UHM-RoSE/instrumentation-and-control/(list of files, cad)

Other CAD files:
EPS/Debug/src/main.obj
EPS/Debug/src/uart.obj
