UHM-RoSE/instrumentation-and-control/(threads)

Thread 1 (2021-10-01):

Design EPS Block Diagram

CraigOpie, 2021-10-01:
Do work for this project in a branch named issue-001:

Design the EPS Block Diagram.  This should be the overall function of the EPS to include charging, discharging, and battery functions.

CraigOpie, 2021-10-01:
Block Diagram is located here:
https://drive.google.com/file/d/1deLKcMdyghD3iEOQf02tignTb7_-ttTG/view?usp=sharing

Closed 2021-10-01.

Thread 10 (2021-10-01):

Create EPS Board File

CraigOpie, 2021-10-01:
Do work for this project in a branch named issue-010:

Create the EPS Board File

Thread 11 (2021-10-01):

Create Bill Of Materials (BOM)

CraigOpie, 2021-10-01:
Do work for this project in a branch named issue-011:

Create the EPS BOM

Closed 2021-12-09.

Thread 13 (2021-10-01):

Implement EPS Register Designation and Memory Allocation Chart

CraigOpie, 2021-10-01:
Do work for this project in a branch named issue-013:

Implement the EPS Register Designation and Memory Allocation Chart to allow for

- [ ] Telemetry
- [ ] Watchdogs and Reset Counters
- [ ] PCM Control
- [ ] PDM Control
- [ ] PDM Timers

Closed 2021-12-09.

Thread 14 (2021-10-01):

Implement Communications Interface

CraigOpie, 2021-10-01:
Do work for this project in a branch named issue-014:

Implement the EPS Communications Interface to allow for

- [x] Setup UART Interrupts (Baud Rate 115200)
- [x] Perform UART Hardware Checks (O-Scope)
- [x] Perform UART Loop Back Test
- [x] Setup I2C Interrupts (Slave)
- [x] Perform I2C Hardware Checks (O-Scope)
- [x] Perform I2C Address and ACK Test
- [x] Command Protocol
- [x] List of Available Commands
        - [ ] Board Status
        - [ ] Get Last Error
        - [ ] Get Version
        - [ ] Get Checksum
        - [ ] Get Telemetry
        - [ ] Get Communications Watchdog Period
        - [ ] Set Communications Watchdog Period
        - [ ] Reset Communications Watchdog
        - [ ] Get Number of Brown-out Resets
        - [ ] Get Number of Auto Software Resets
        - [ ] Get Number of Manual Resets
        - [ ] Get Number of Communications Watchdog Resets
        - [ ] Switch ON All PDMs
        - [ ] Switch OFF All PDMs
        - [ ] Get Actual State of All PDMs
        - [ ] Get Expected State of All PDMs
        - [ ] Get Initial State of All PDMs
        - [ ] Set All PDMs to Initial State
        - [ ] Switch PDM-N "ON"
        - [ ] Switch PDM-N "OFF"
        - [ ] Set PDM-N's Initial State to "ON"
        - [ ] Set PDM-N's Initial State to "OFF"
        - [ ] Get PDM-N's Actual Status
        - [ ] Set PDM-N's Timer Limit
        - [ ] Get PDM-N's Timer Limit
        - [ ] Get PDM-N's Current Timer Value
        - [ ] PCM Reset
        - [ ] Manual Reset

Closed 2021-12-09.

Thread 15 (2021-10-01):

Finalize Schematic Design

CraigOpie, 2021-10-01:
Do work for this project in a branch named issue-015:

Finalize the Schematic Design

Closed 2021-12-09.

Thread 16 (2021-10-01):

Finalize Board Design

CraigOpie, 2021-10-01:
Do work for this project in a branch named issue-016:

Finalize the Board Design

Thread 17 (2021-10-01):

Assemble Final Board

CraigOpie, 2021-10-01:
Do work for this project in a branch named issue-017:

Assemble the Final Board

Thread 18 (2021-10-01):

Test the Final Board

CraigOpie, 2021-10-01:
Do work for this project in a branch named issue-018:

Test the Final Board

- [ ] Power Input Module
- [ ] Power Conditioning Module
- [ ] Power Distribution Module
- [ ] Battery Cells
- [ ] Communicate with EPS

Thread 2 (2021-10-01):

Select Components for the Power Input Module

CraigOpie, 2021-10-01:
Do work for this project in a branch named issue-002:

Select Components for the Power Input Module to allow charging the battery or running power from a non-battery power supply.

Closed 2021-12-09.

Thread 3 (2021-10-01):

Select Components for the Battery Maintaining Module

CraigOpie, 2021-10-01:
Do work for this project in a branch named issue-003:

Select Components for the Battery Maintaining Module to allow balanced charging of the battery cells, monitoring temperatures, and telemetry.

Closed 2021-12-09.

Thread 4 (2021-10-01):

Select Components for the Power Conditioning Module

CraigOpie, 2021-10-01:
Do work for this project in a branch named issue-004:

Select Components for the Power Conditioning Module to allow required protective features to the power supply voltage buses.

Closed 2021-12-09.

Thread 5 (2021-10-01):

Select Components for the Power Distribution Module

CraigOpie, 2021-10-01:
Do work for this project in a branch named issue-005:

Select Components for the Power Distribution Module to allow required protective features to the power supply switched outputs.

Closed 2021-12-09.

Thread 6 (2021-10-01):

Create Power Input Circuit Schematic

CraigOpie, 2021-10-01:
Do work for this project in a branch named issue-006:

Create the Power Input Circuit Schematic Page

Closed 2021-12-09.

Thread 7 (2021-10-01):

Create Battery Maintaining Circuit Schematic

CraigOpie, 2021-10-01:
Do work for this project in a branch named issue-007:

Create the Battery Maintaining Circuit Schematic Page

Closed 2021-12-09.

Thread 8 (2021-10-01):

Create Power Conditioning Module Schematic

CraigOpie, 2021-10-01:
Do work for this project in a branch named issue-008:

Create the Power Conditioning Module Schematic Page

Closed 2021-12-09.

Thread 9 (2021-10-01):

Create Power Distribution Module Schematic

CraigOpie, 2021-10-01:
Do work for this project in a branch named issue-009:

Create the Power Distribution Module Schematic Page

Closed 2021-12-09.
