UHM-RoSE/instrumentation-and-control/Documentation/EPS Schematic/eps.pdf

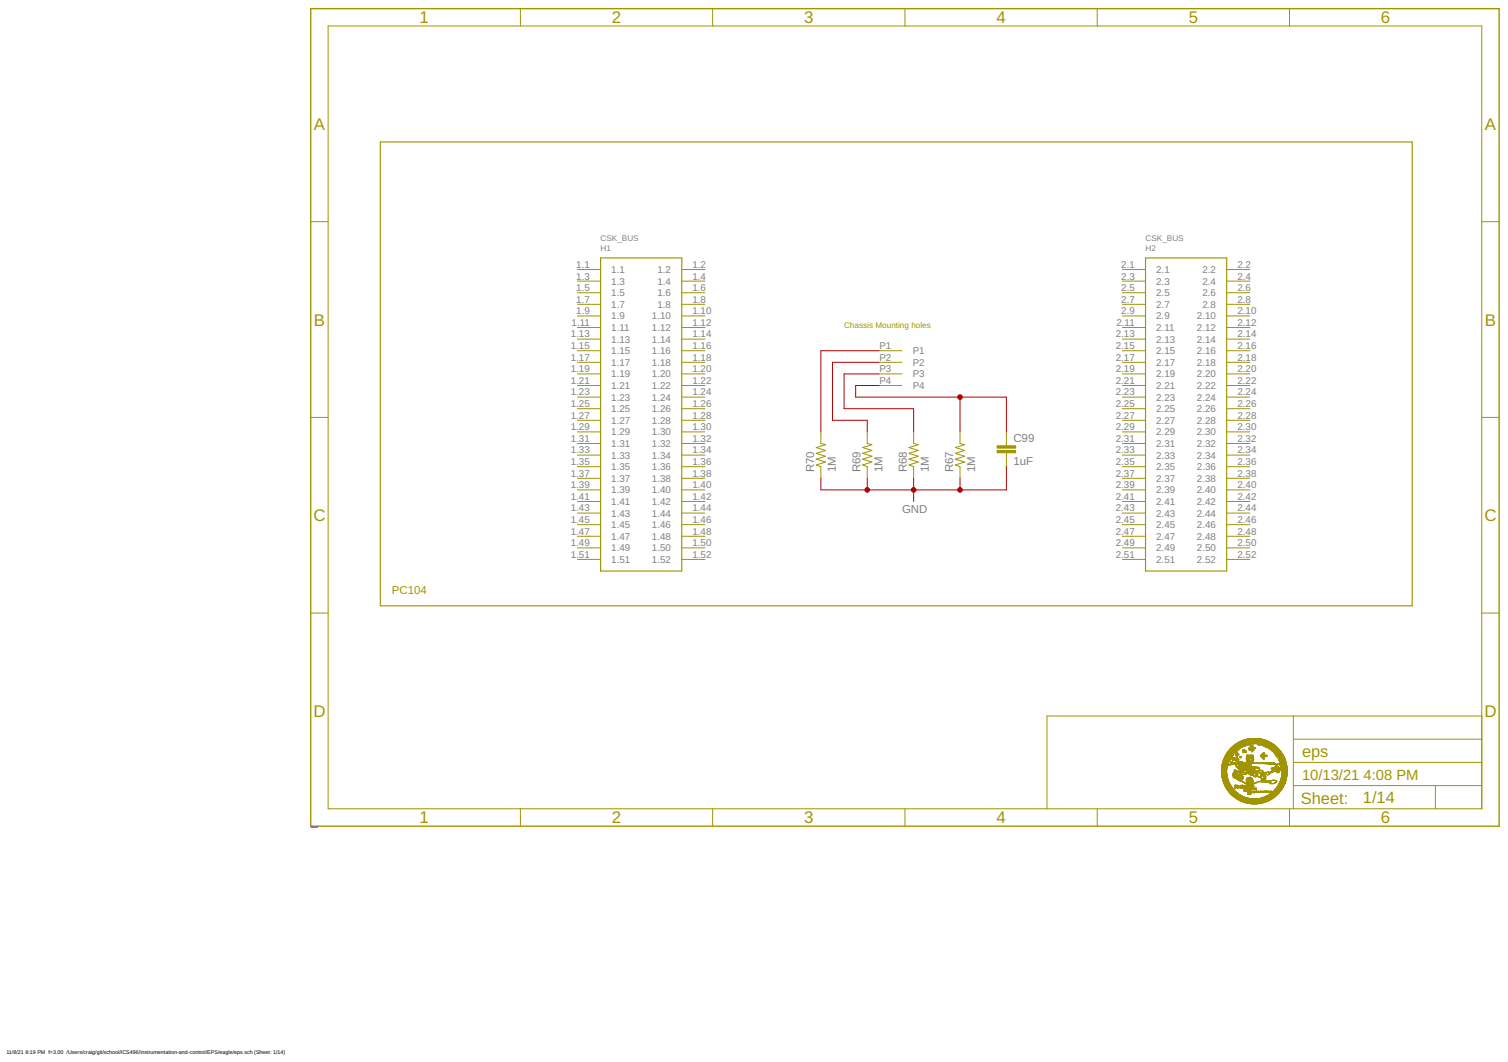
[picture p3: page 1]

11/8/21 8:19 PM f=3.00 /Users/craig/git/school/ICS496/instrumentation-and-control/EPS/eagle/eps.sch (Sheet: 1/14)

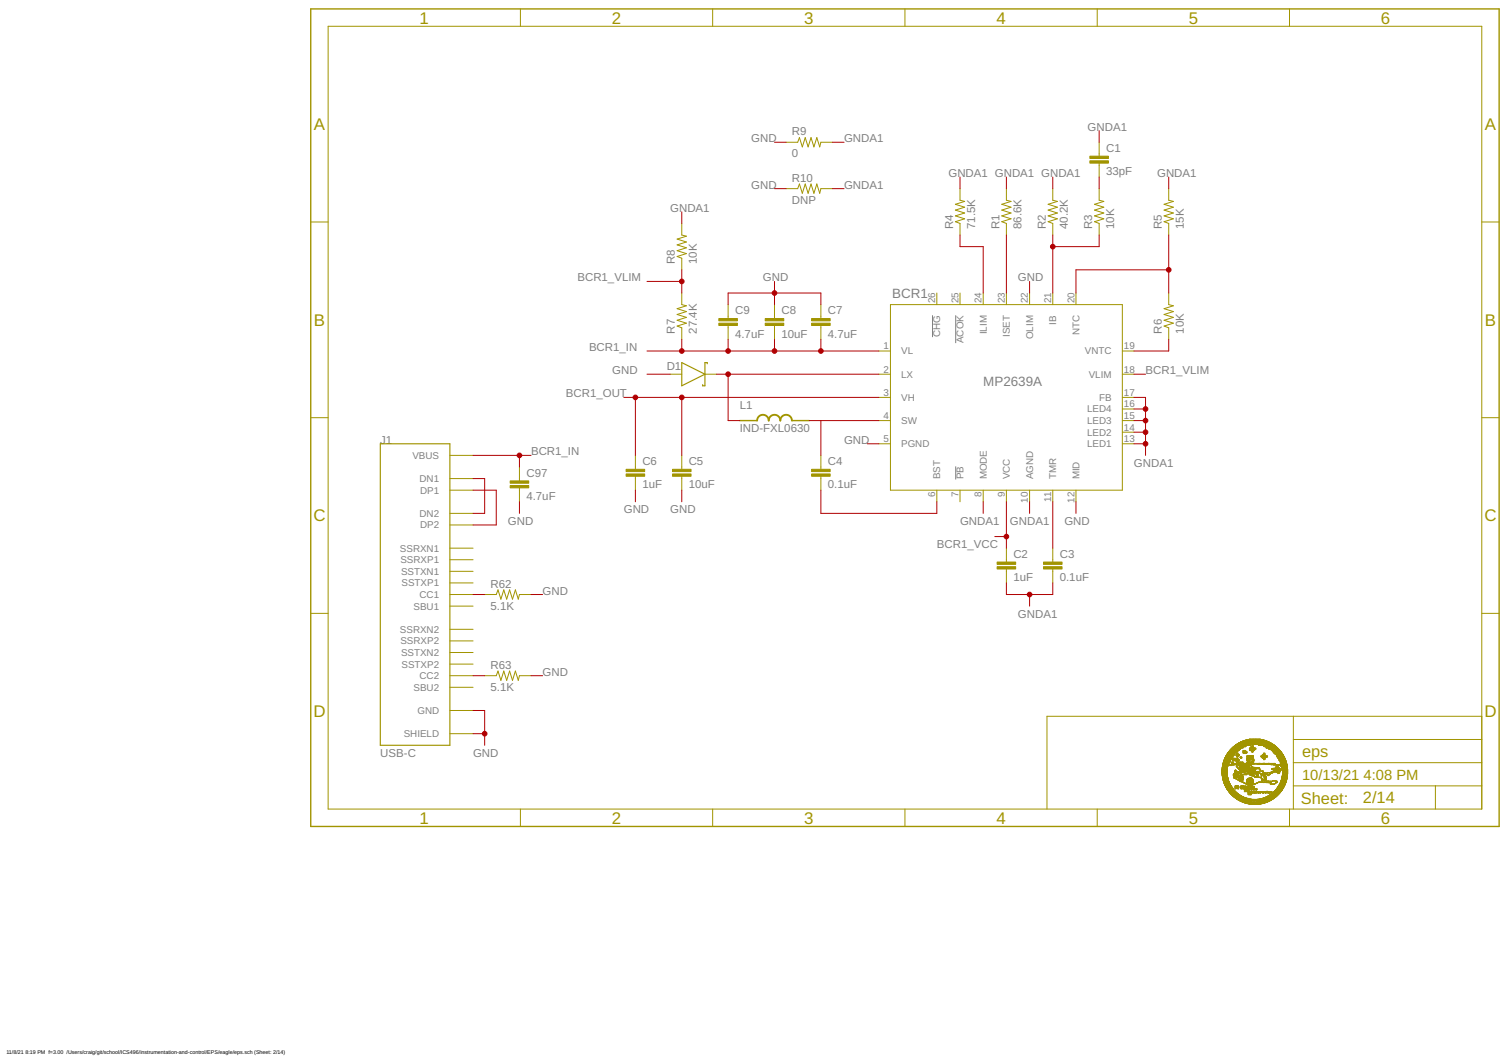
[picture p4: page 2]

11/8/21 8:19 PM f=3.00 /Users/craig/git/school/ICS496/instrumentation-and-control/EPS/eagle/eps.sch (Sheet: 2/14)

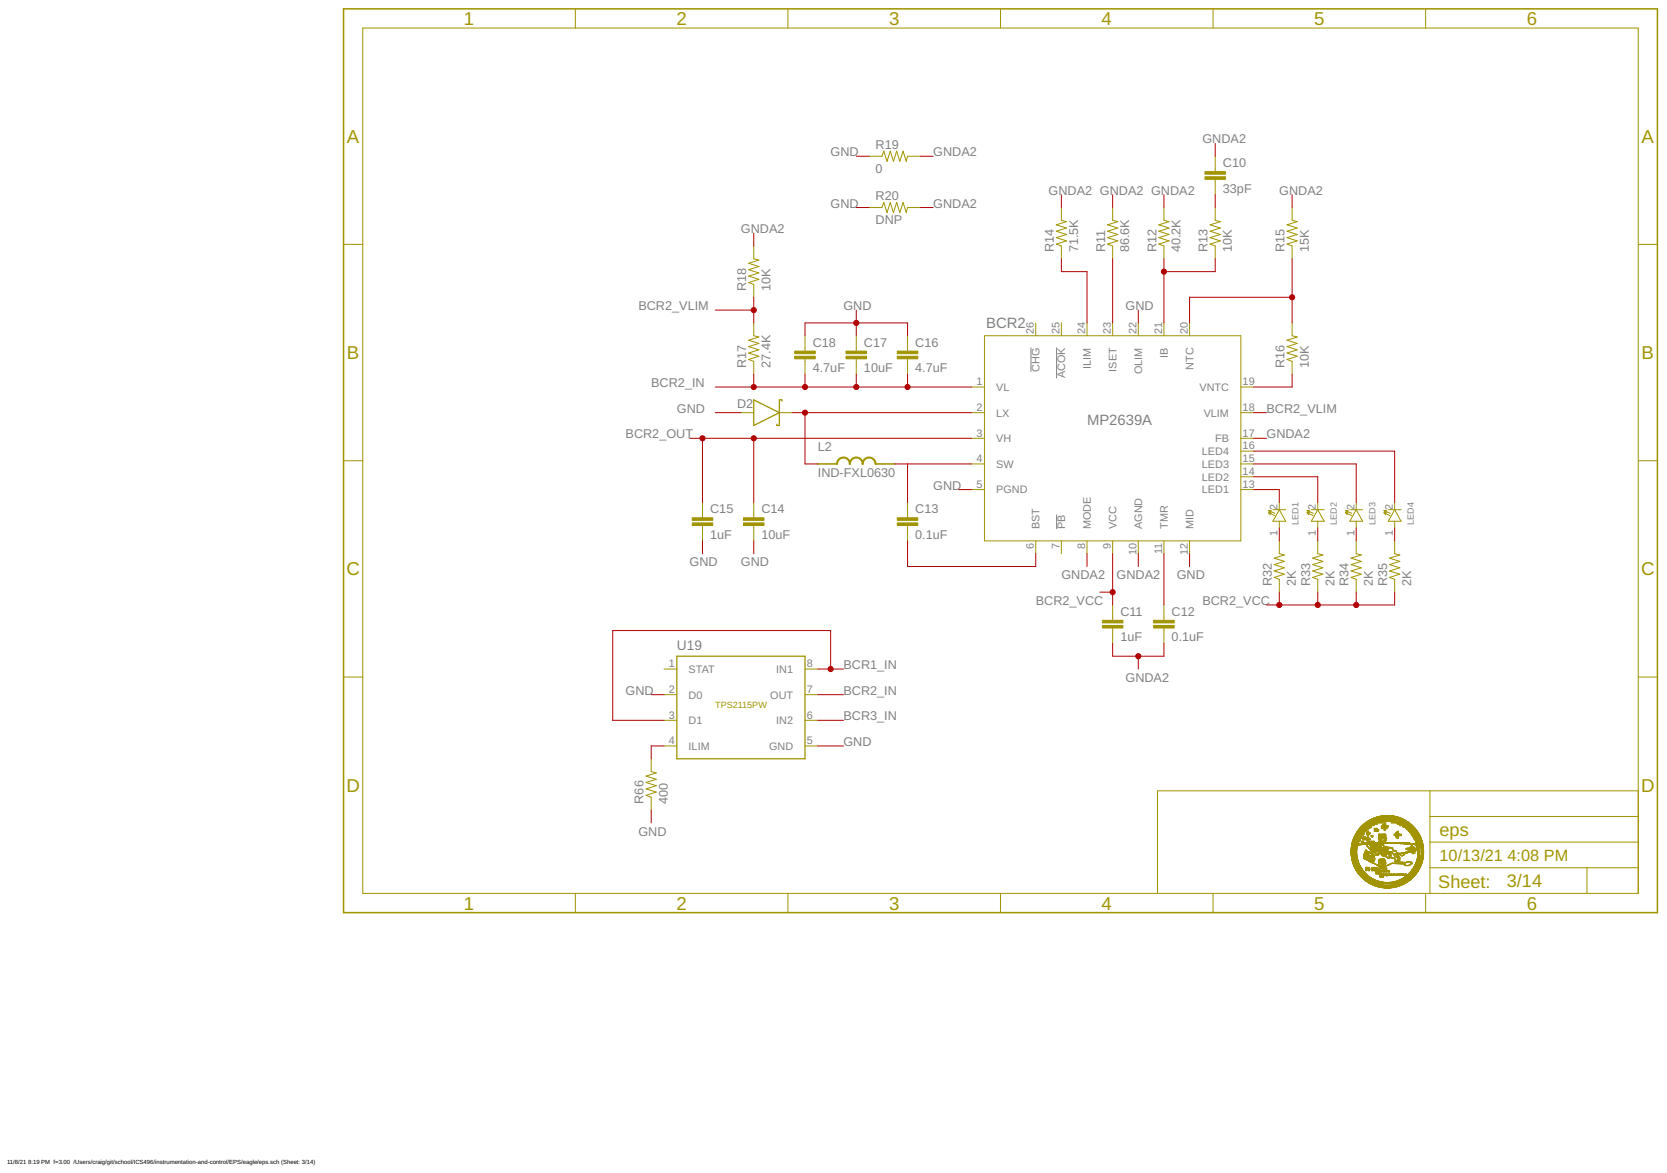
[picture p5: page 3]

11/8/21 8:19 PM f=3.00 /Users/craig/git/school/ICS496/instrumentation-and-control/EPS/eagle/eps.sch (Sheet: 3/14)

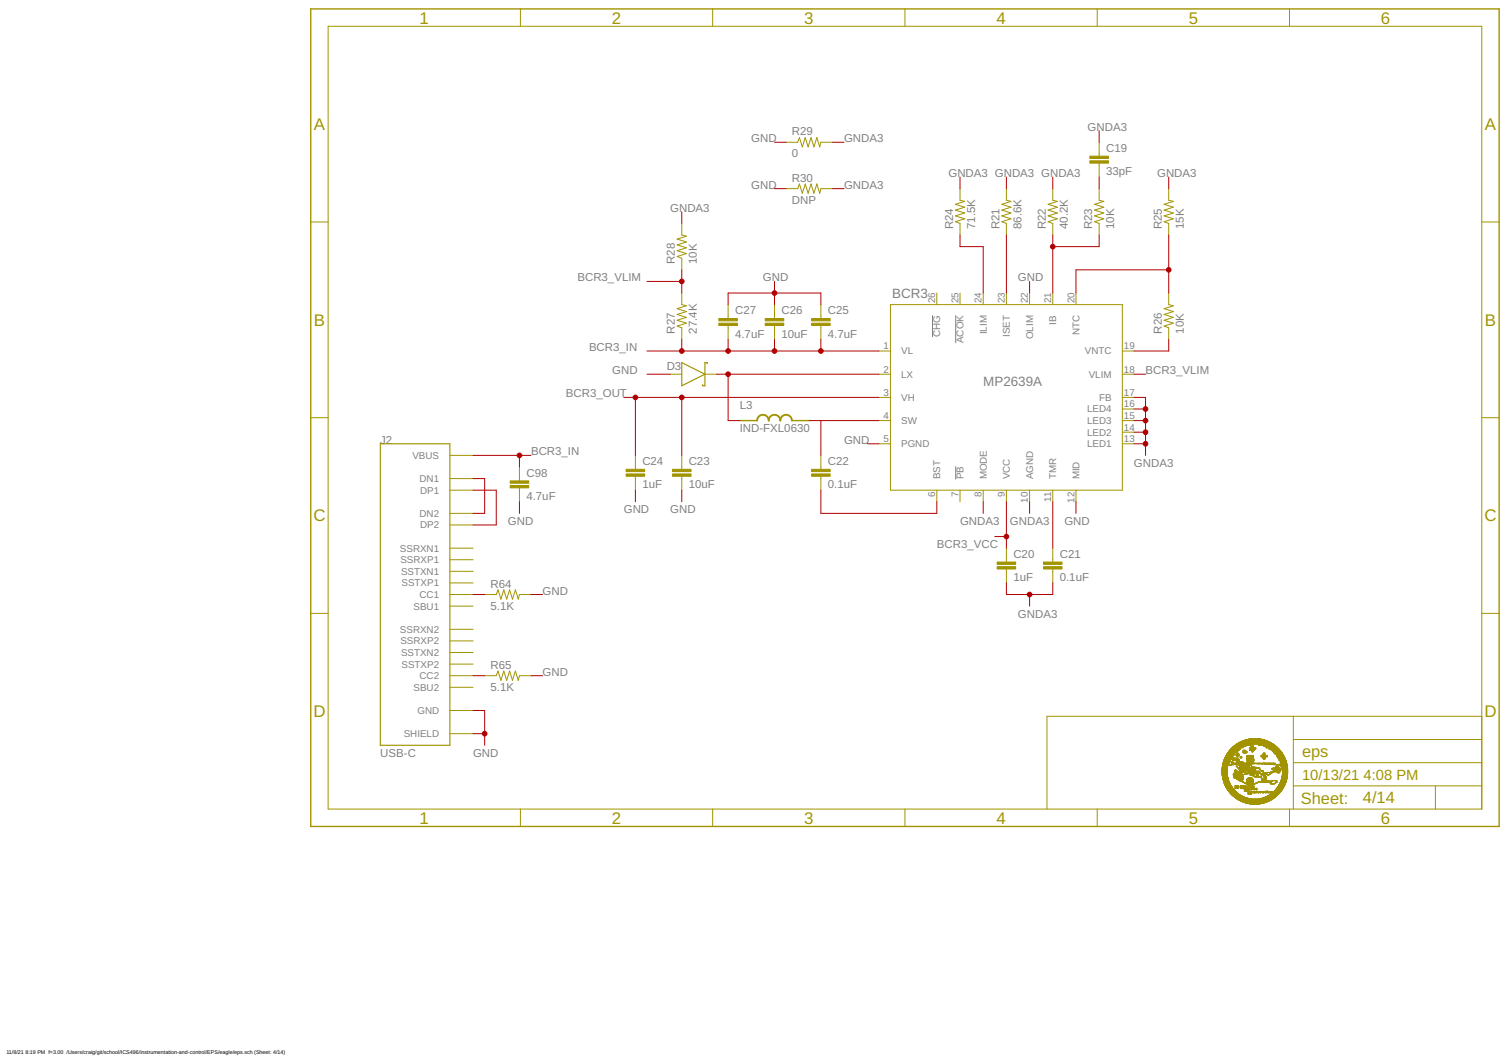
[picture p6: page 4]

11/8/21 8:19 PM f=3.00 /Users/craig/git/school/ICS496/instrumentation-and-control/EPS/eagle/eps.sch (Sheet: 4/14)

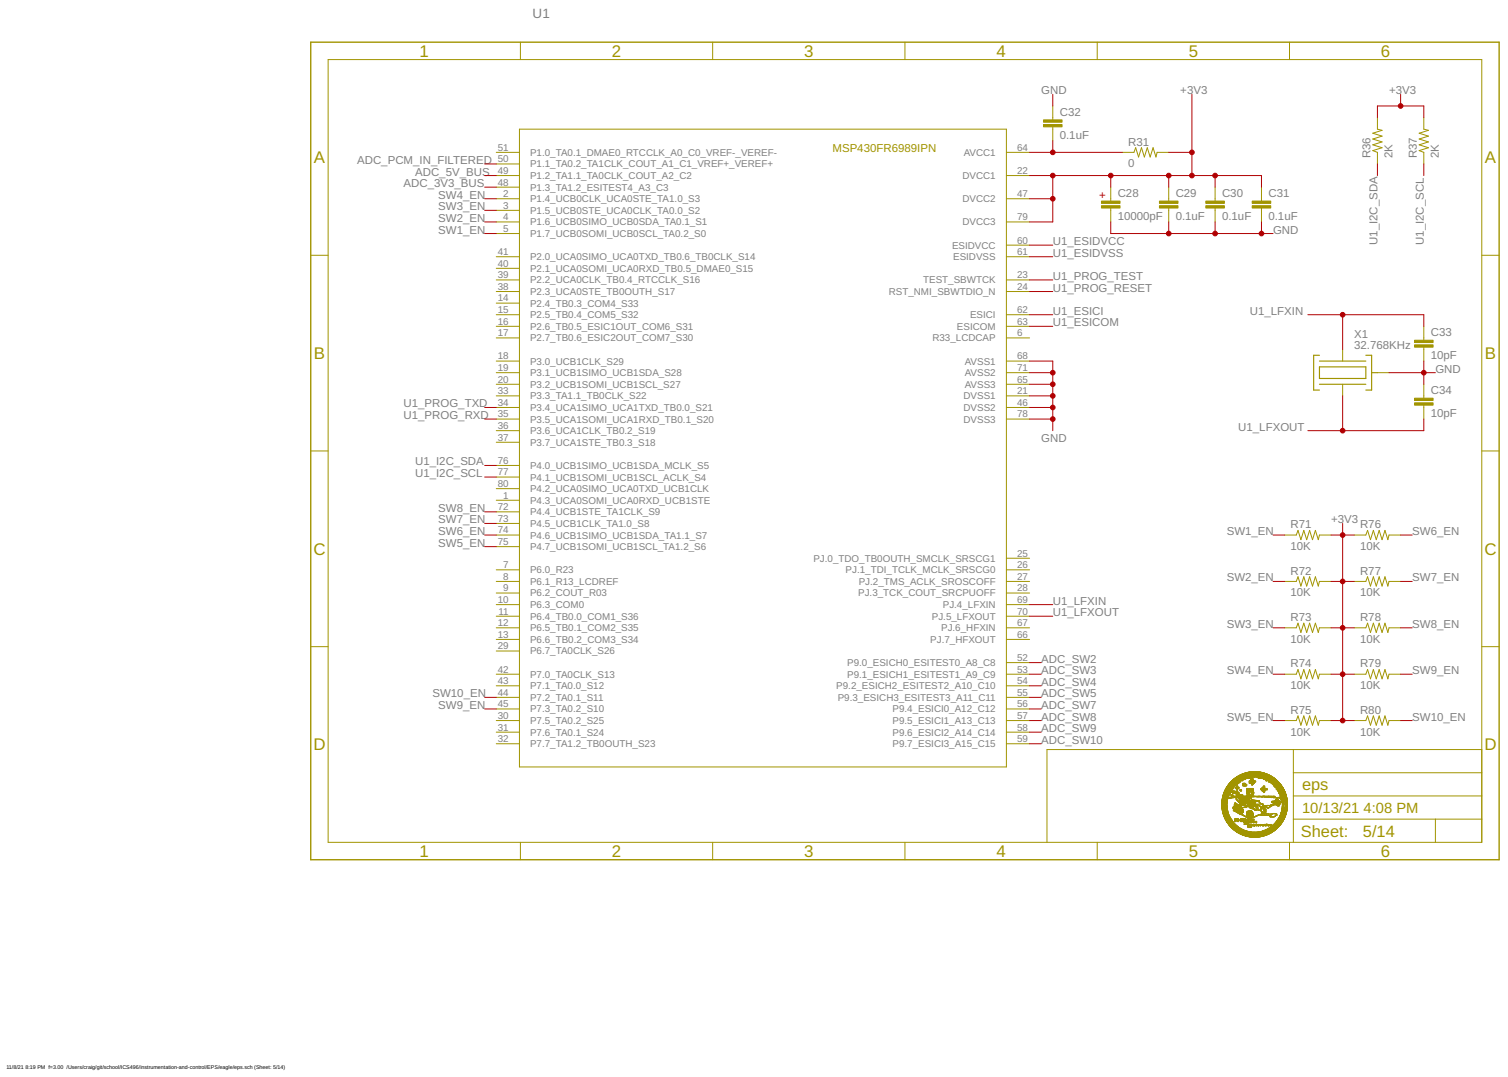
[picture p7: page 5]

11/8/21 8:19 PM f=3.00 /Users/craig/git/school/ICS496/instrumentation-and-control/EPS/eagle/eps.sch (Sheet: 5/14)

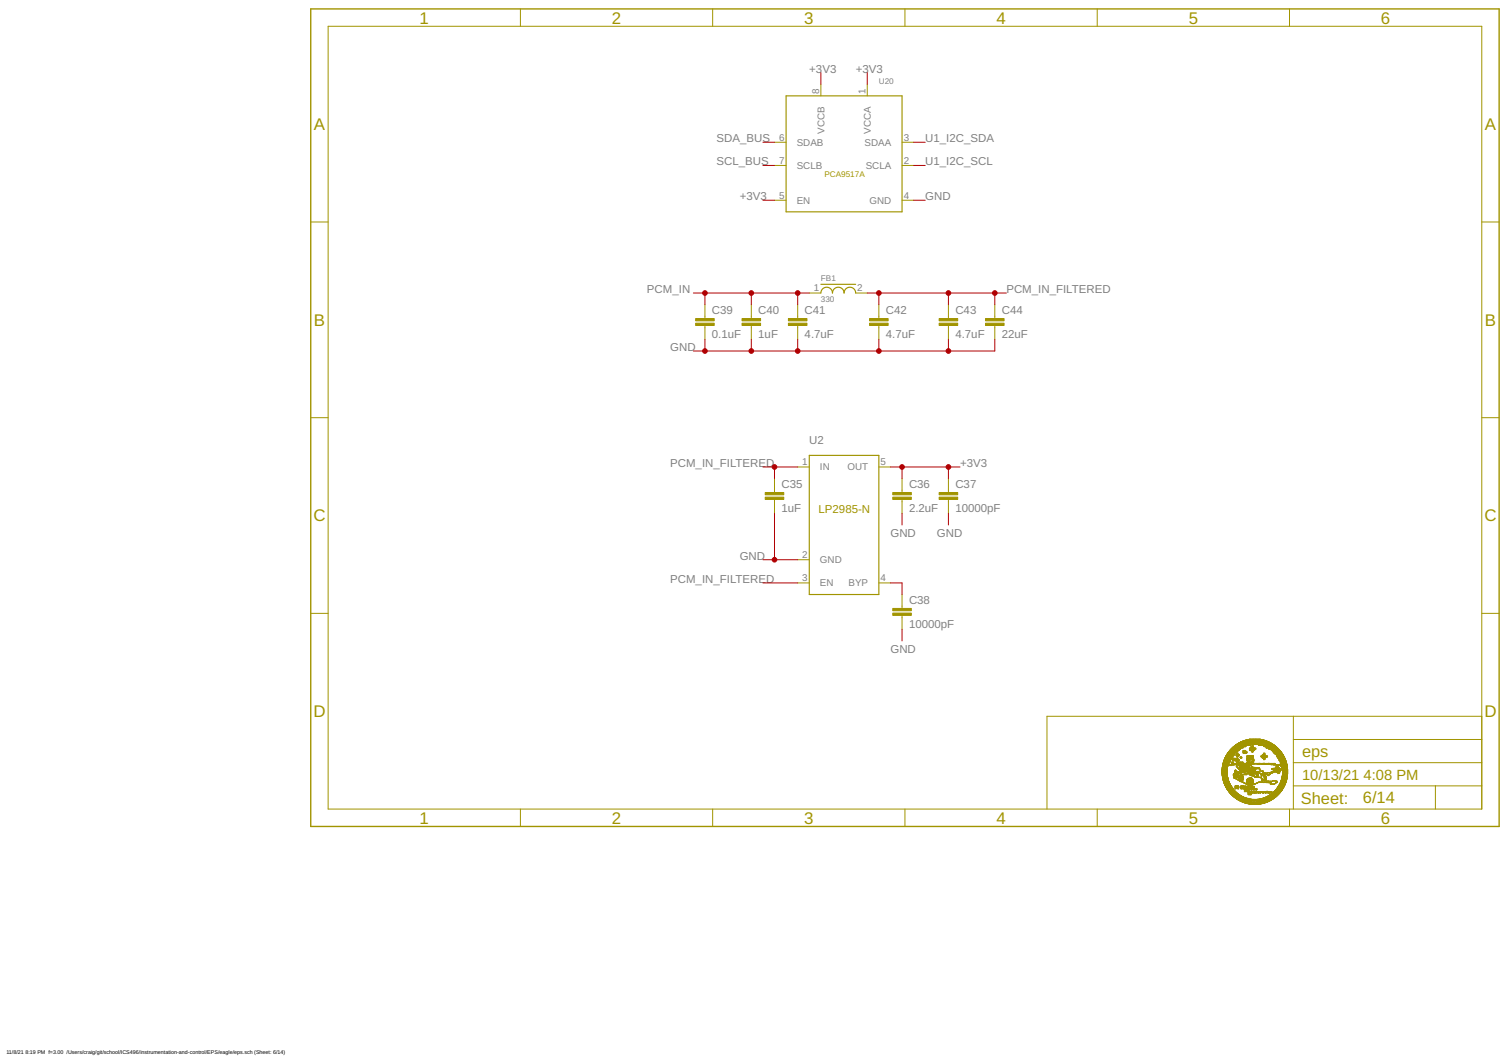
[picture p8: page 6]

11/8/21 8:19 PM f=3.00 /Users/craig/git/school/ICS496/instrumentation-and-control/EPS/eagle/eps.sch (Sheet: 6/14)

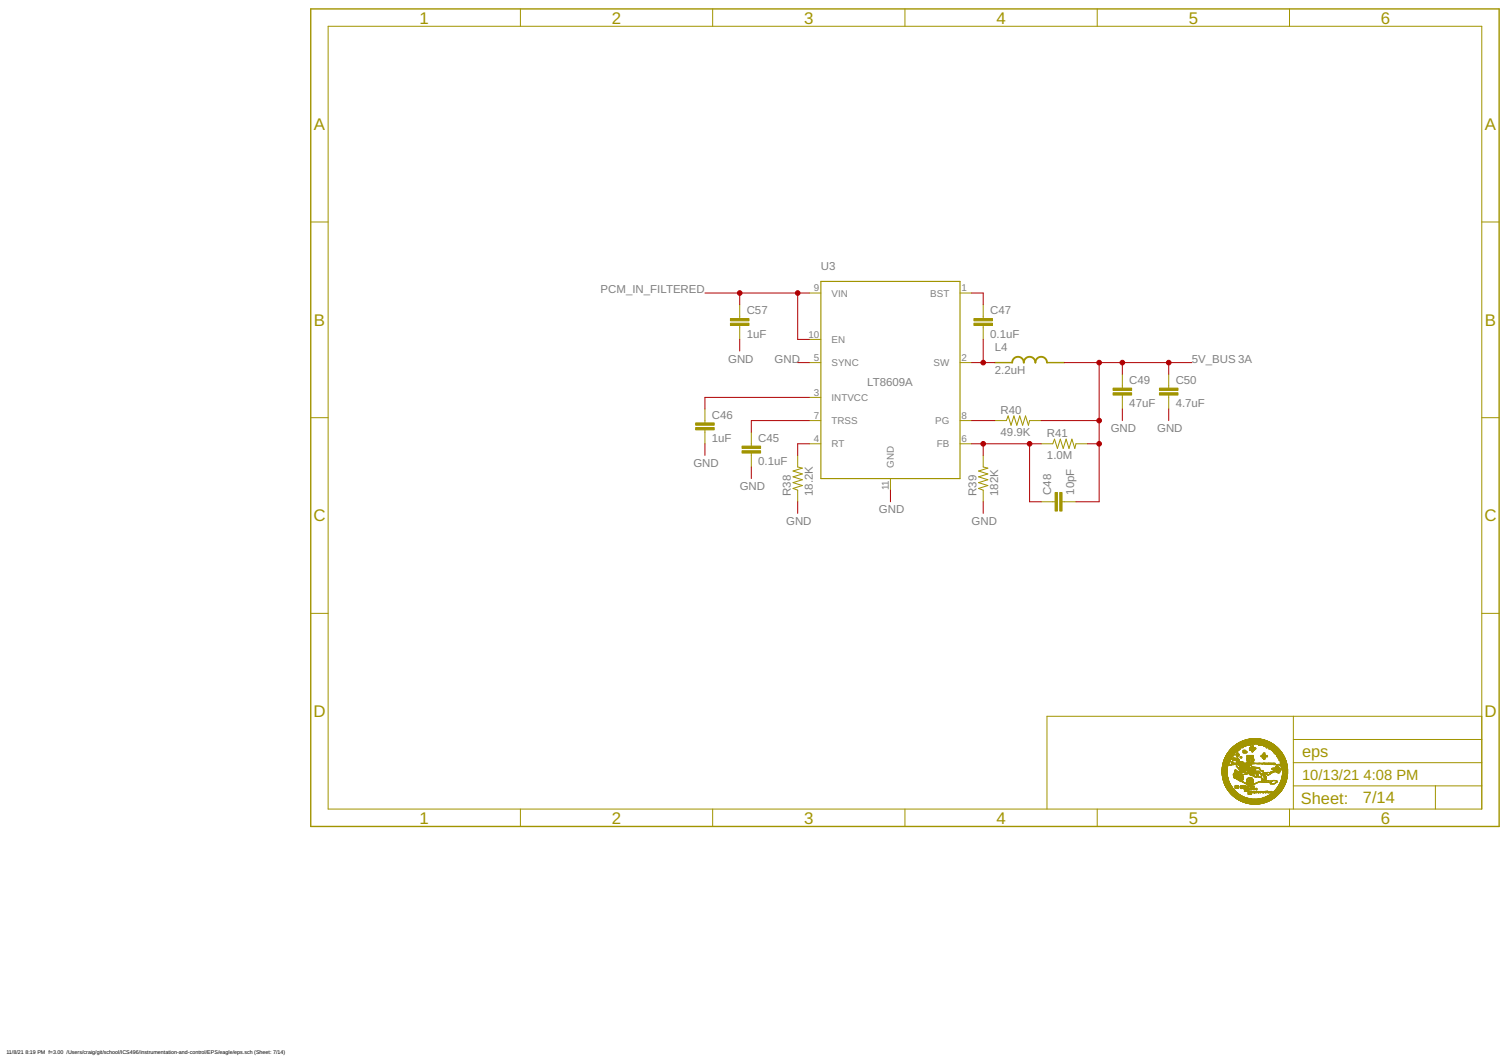
[picture p9: page 7]

11/8/21 8:19 PM f=3.00 /Users/craig/git/school/ICS496/instrumentation-and-control/EPS/eagle/eps.sch (Sheet: 7/14)

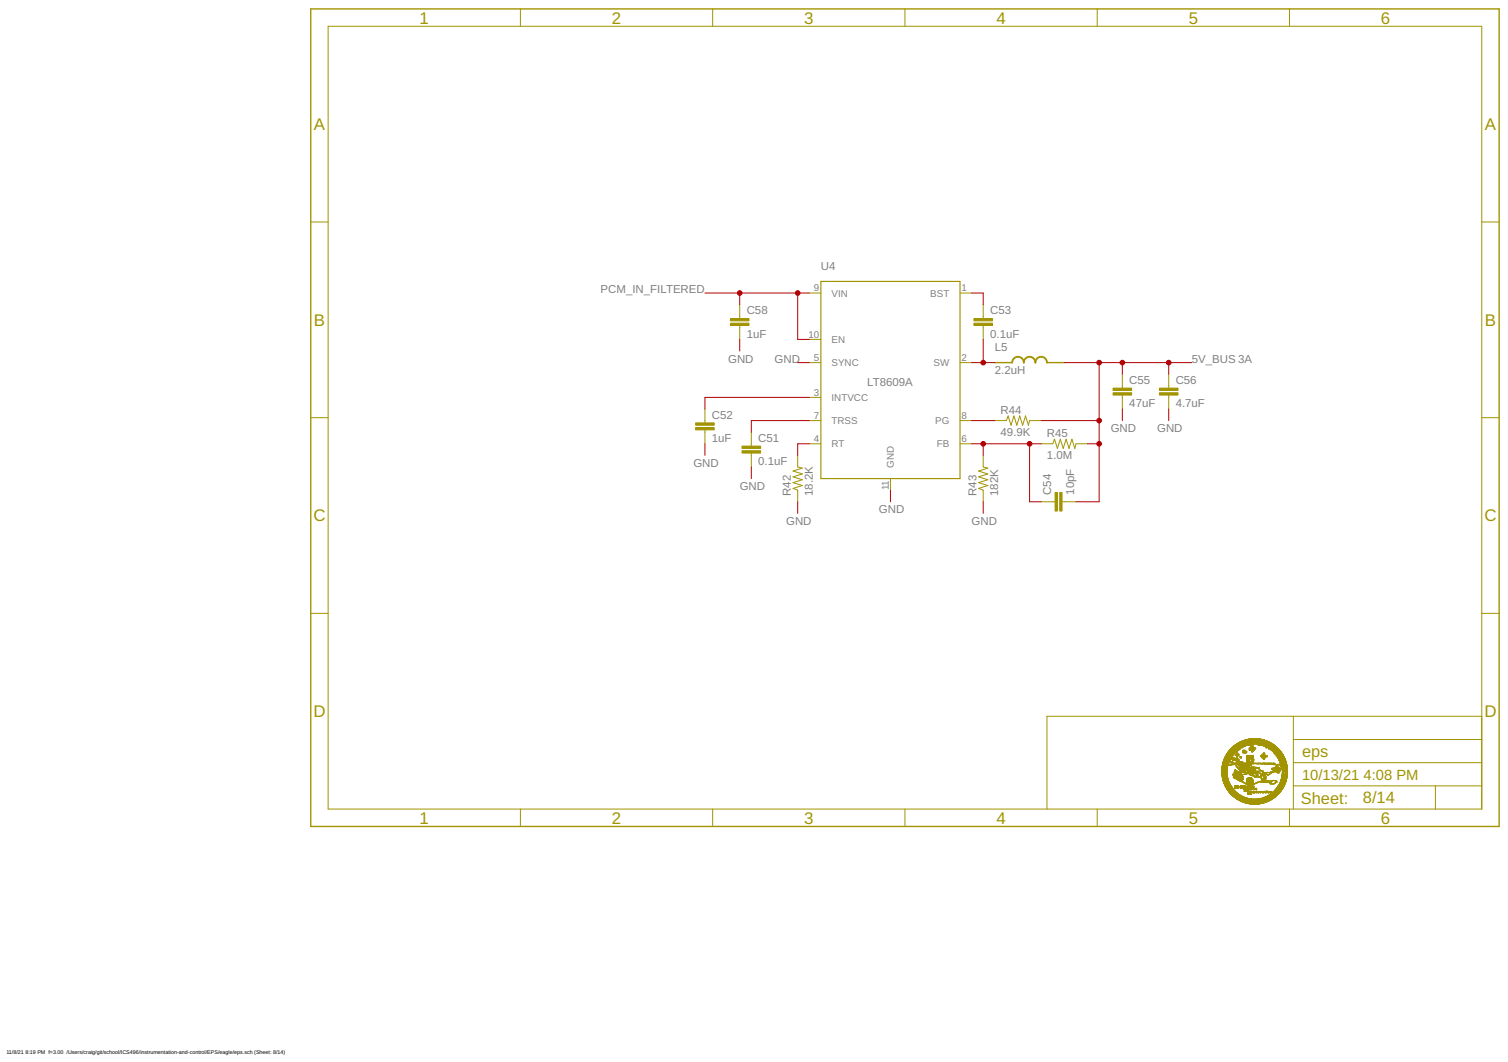
[picture p10: page 8]

11/8/21 8:19 PM f=3.00 /Users/craig/git/school/ICS496/instrumentation-and-control/EPS/eagle/eps.sch (Sheet: 8/14)

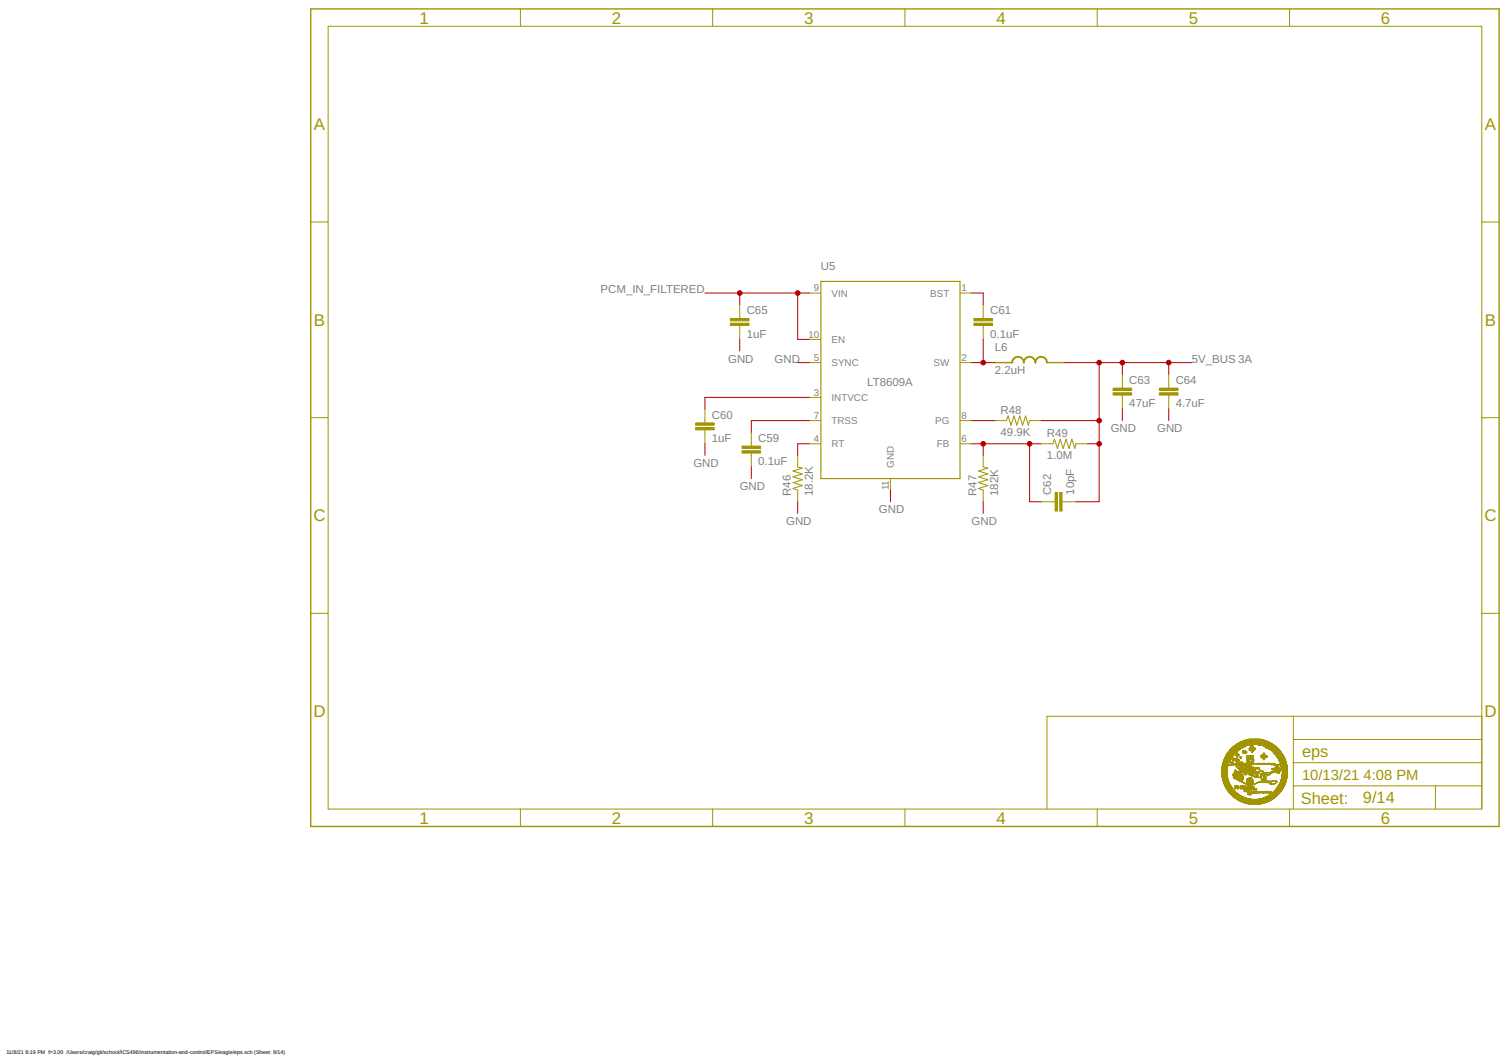
[picture p11: page 9]

11/8/21 8:19 PM f=3.00 /Users/craig/git/school/ICS496/instrumentation-and-control/EPS/eagle/eps.sch (Sheet: 9/14)

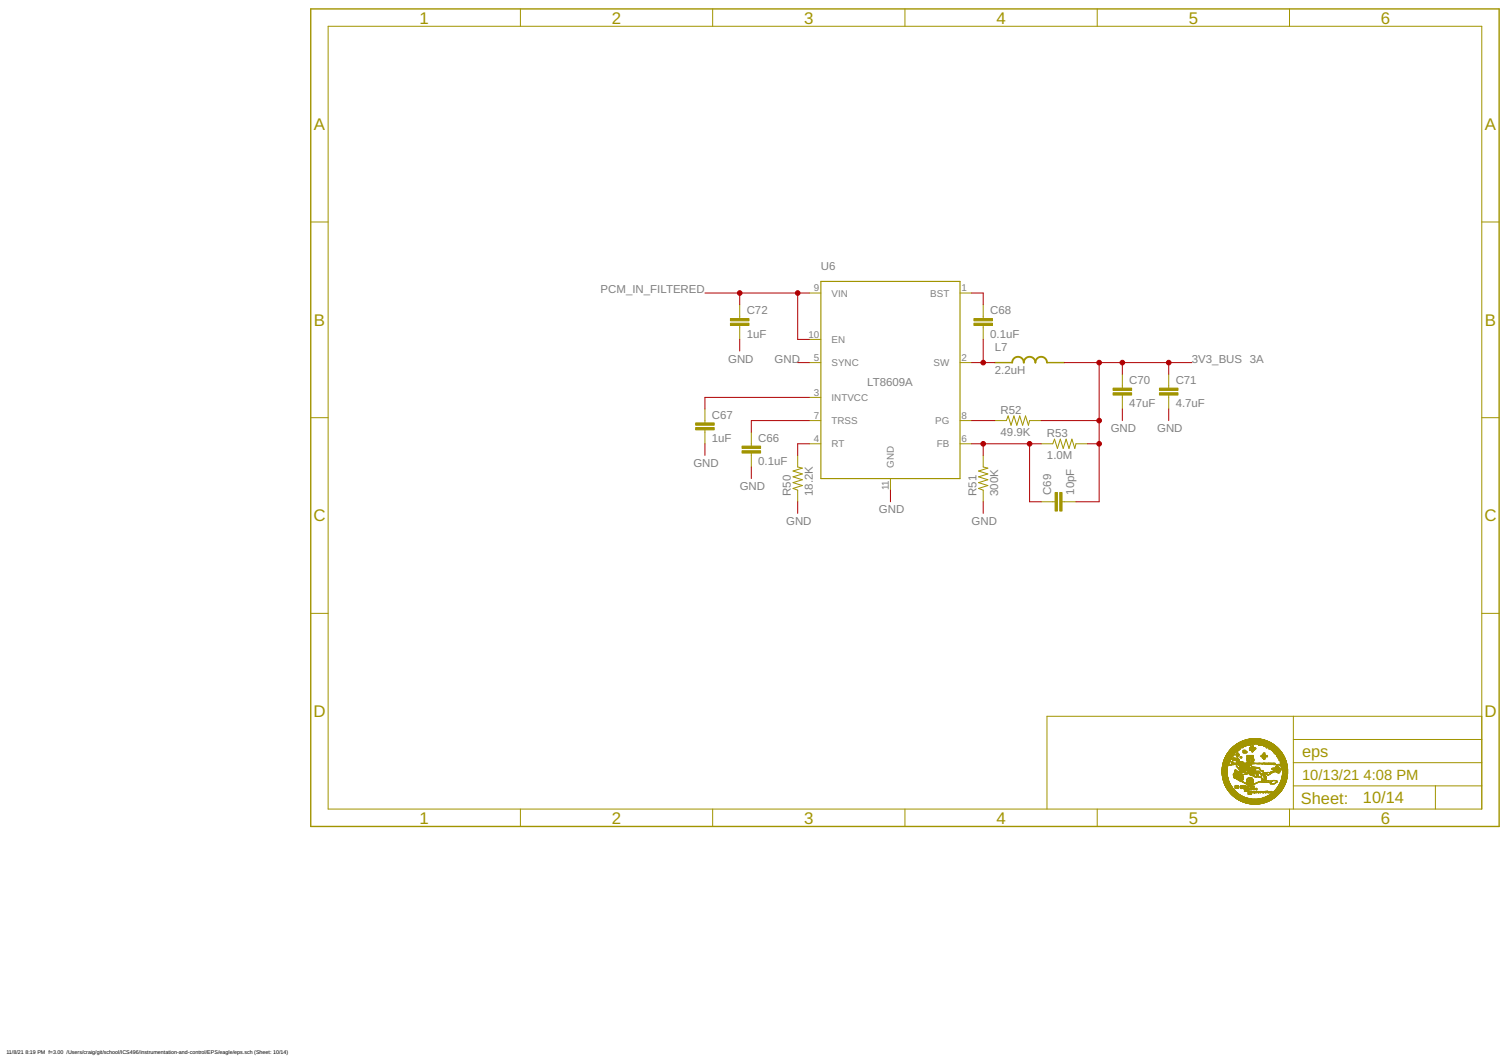
[picture p12: page 10]

11/8/21 8:19 PM f=3.00 /Users/craig/git/school/ICS496/instrumentation-and-control/EPS/eagle/eps.sch (Sheet: 10/14)

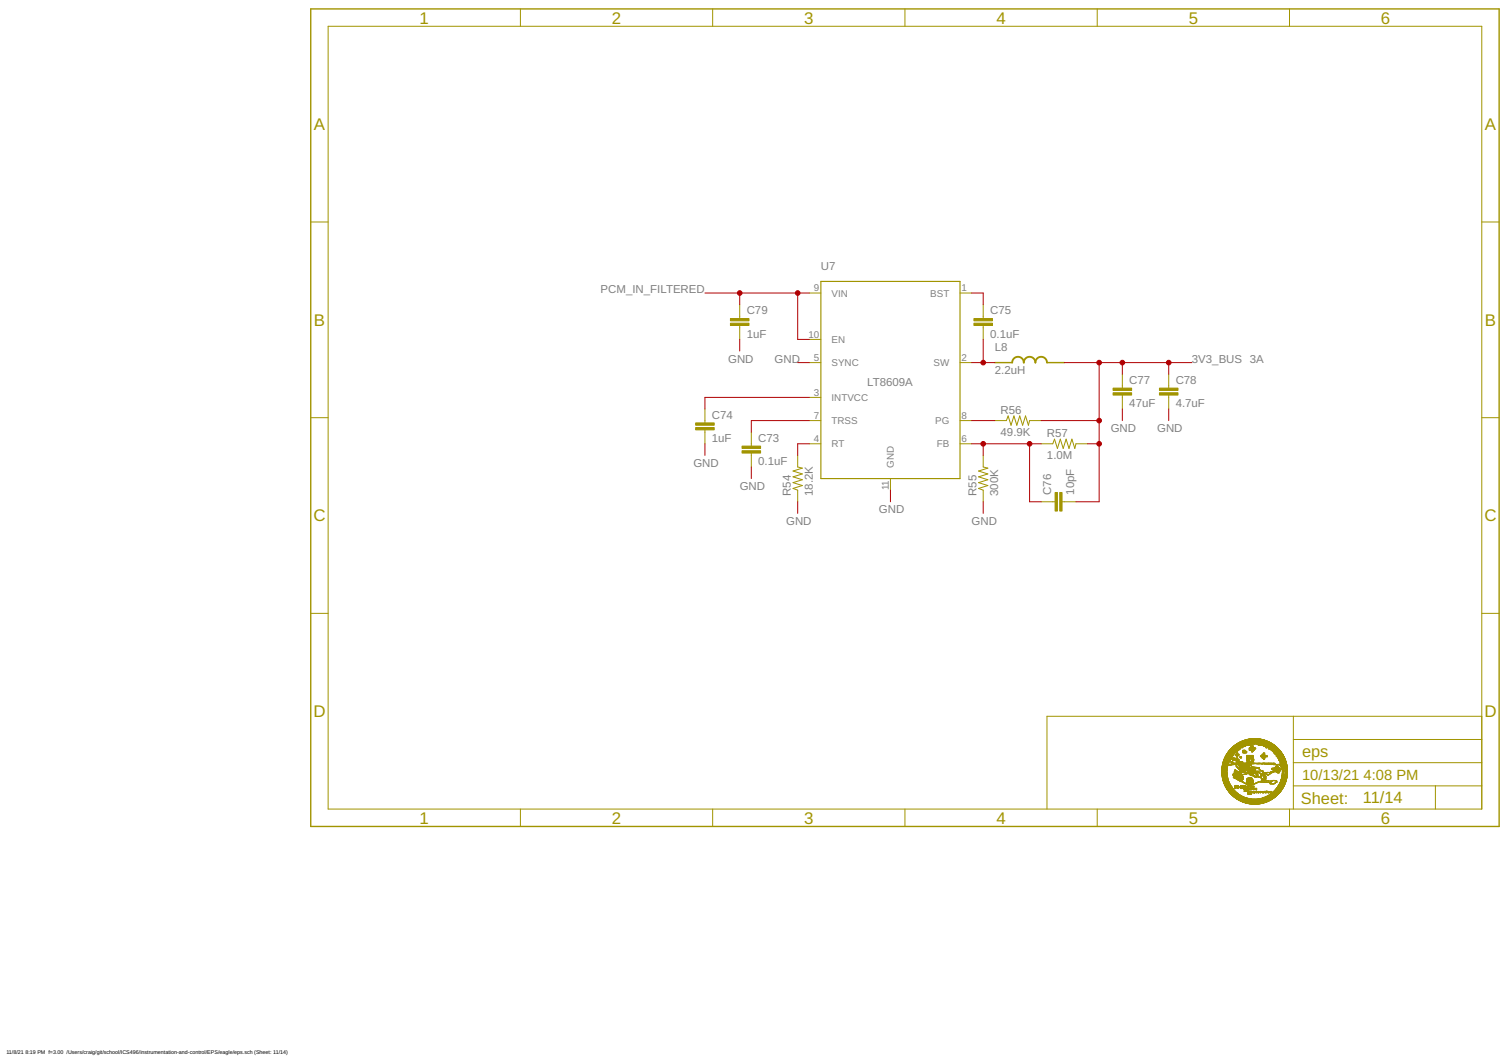
[picture p13: page 11]

11/8/21 8:19 PM f=3.00 /Users/craig/git/school/ICS496/instrumentation-and-control/EPS/eagle/eps.sch (Sheet: 11/14)

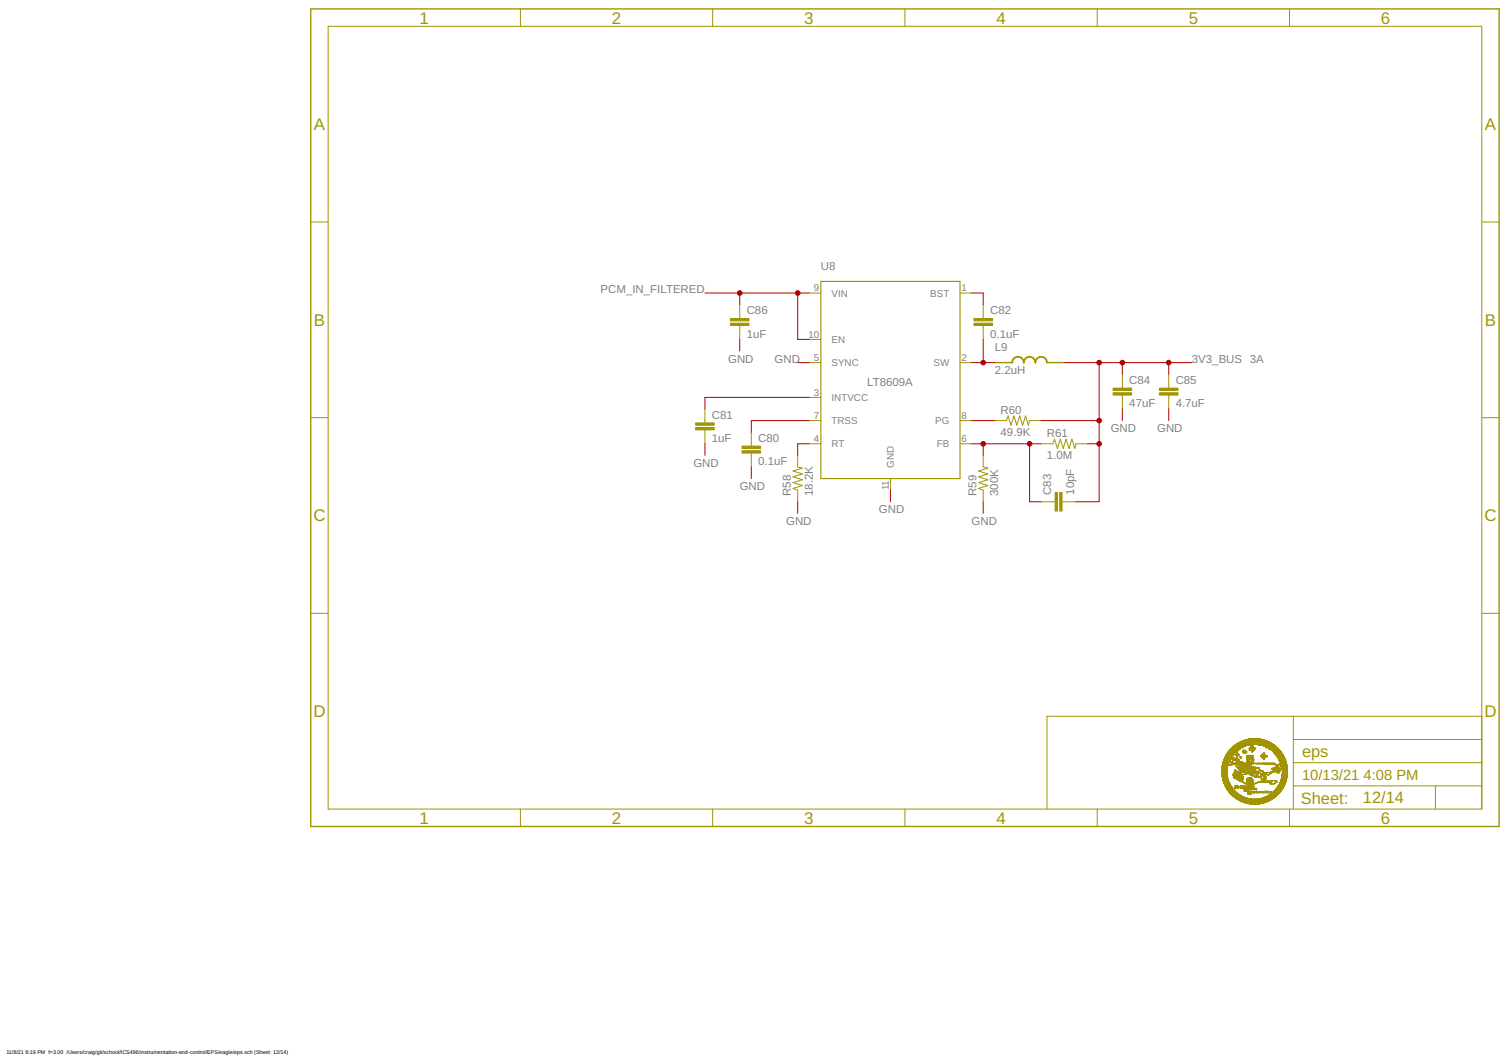
[picture p14: page 12]

11/8/21 8:19 PM f=3.00 /Users/craig/git/school/ICS496/instrumentation-and-control/EPS/eagle/eps.sch (Sheet: 12/14)

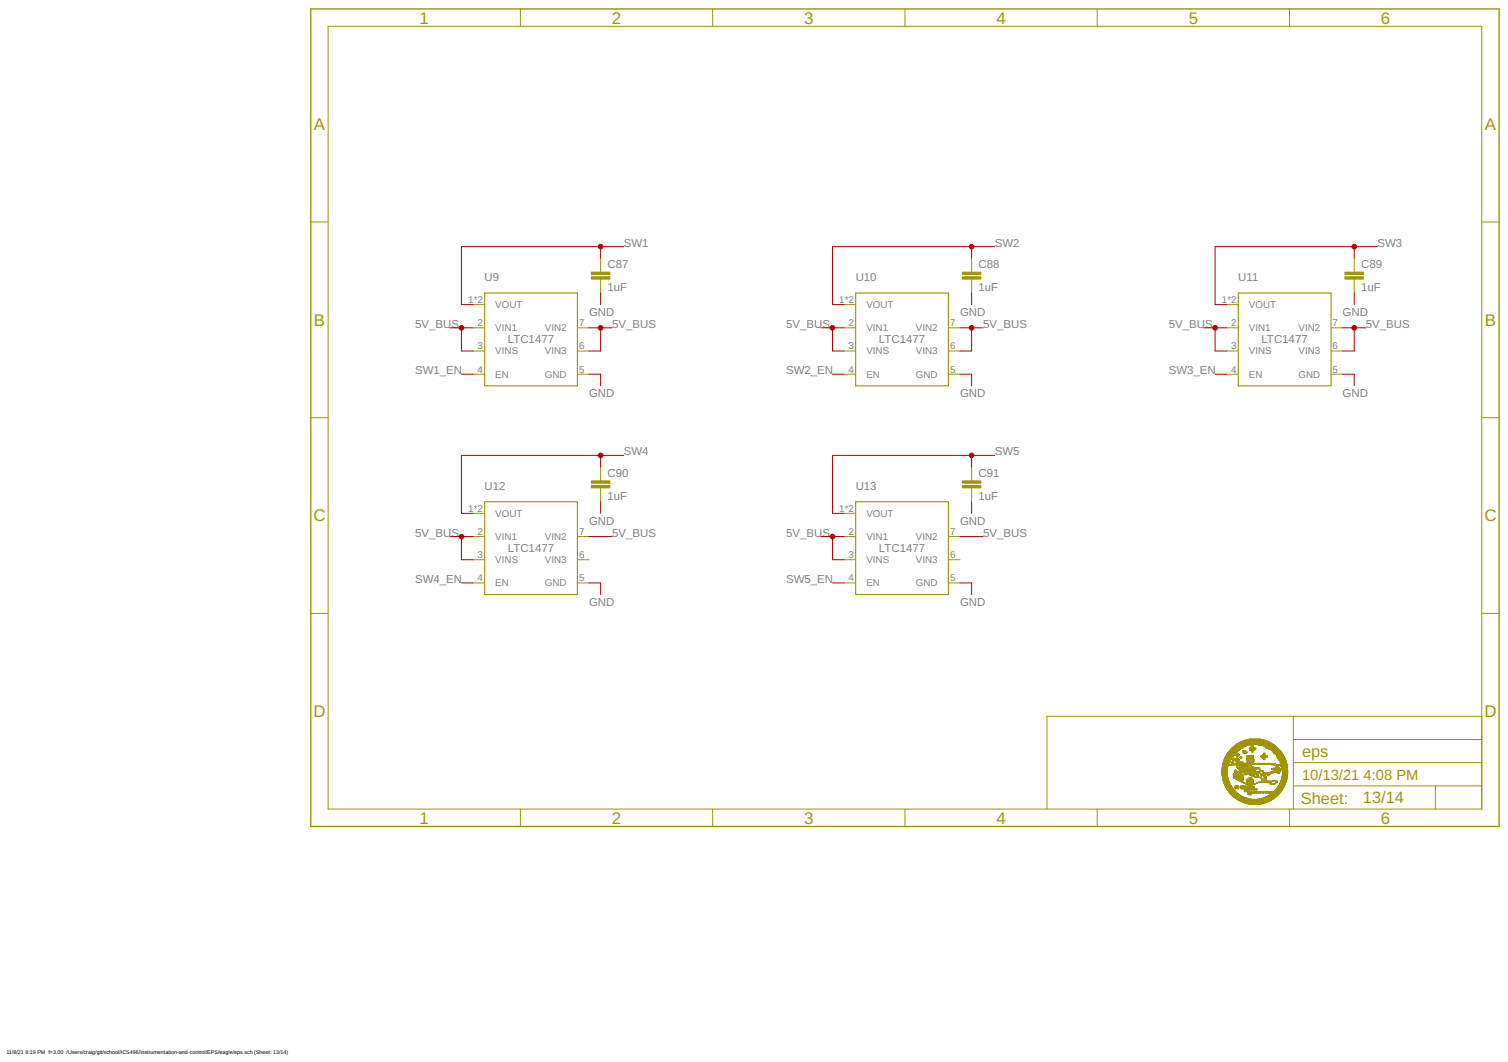
[picture p15: page 13]

11/8/21 8:19 PM f=3.00 /Users/craig/git/school/ICS496/instrumentation-and-control/EPS/eagle/eps.sch (Sheet: 13/14)

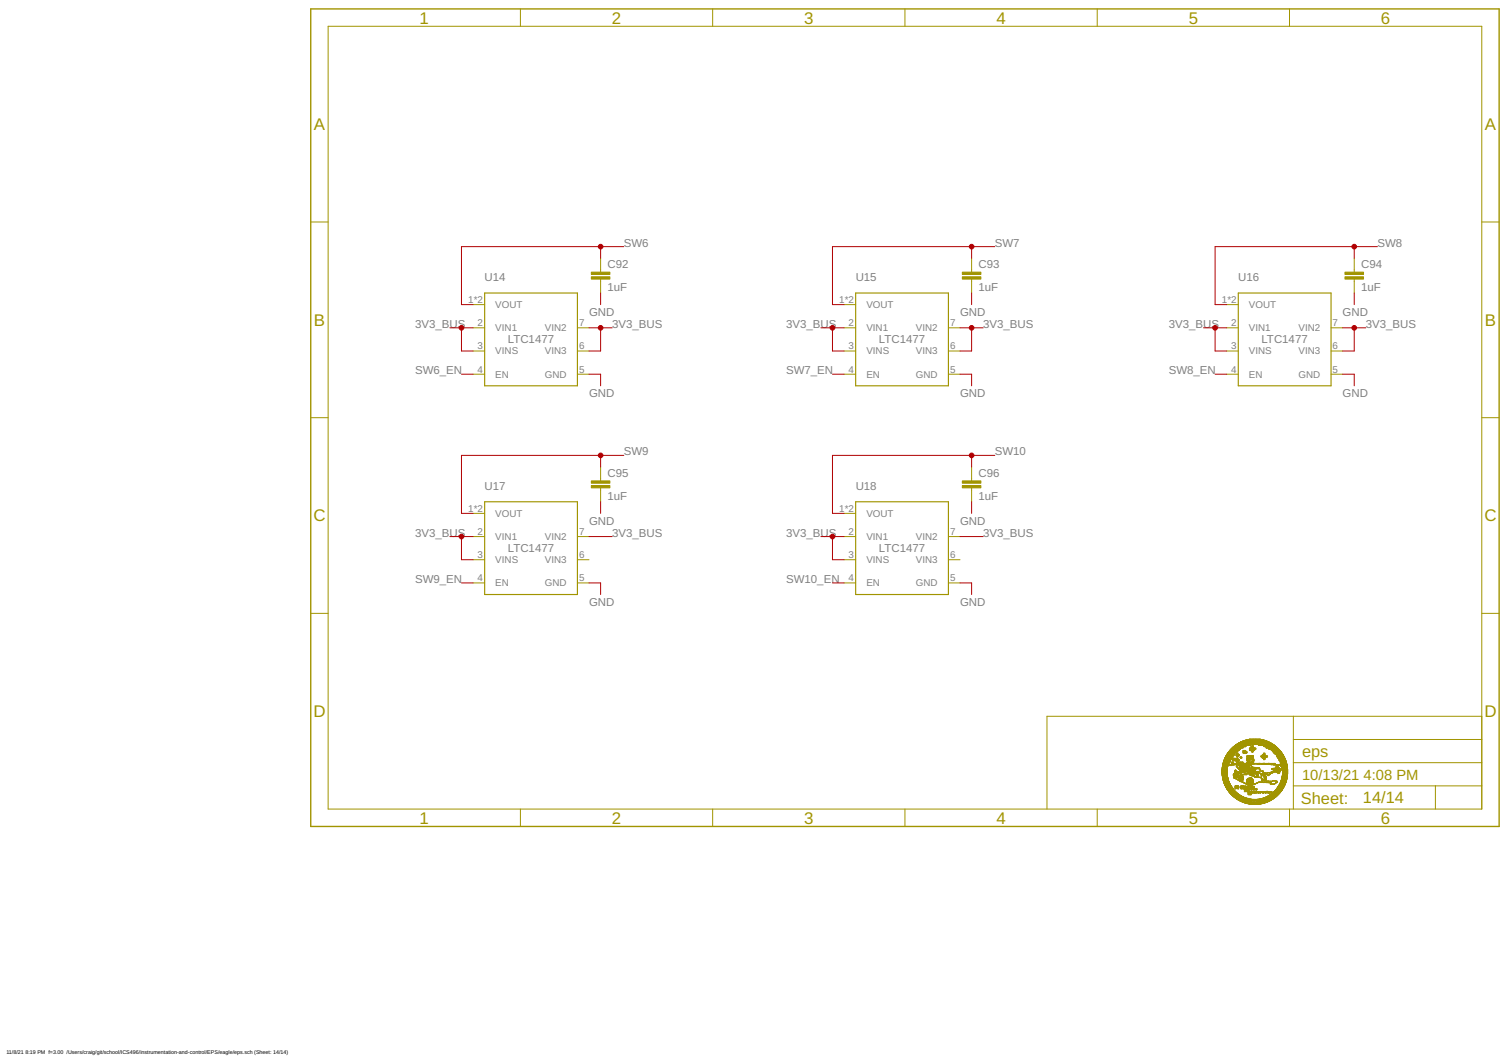
[picture p16: page 14]

11/8/21 8:19 PM f=3.00 /Users/craig/git/school/ICS496/instrumentation-and-control/EPS/eagle/eps.sch (Sheet: 14/14)
