UHM-RoSE/instrumentation-and-control/EPS/eagle/eps.sch

## EAGLE design EPS/eagle/eps.sch (2021-10-13)

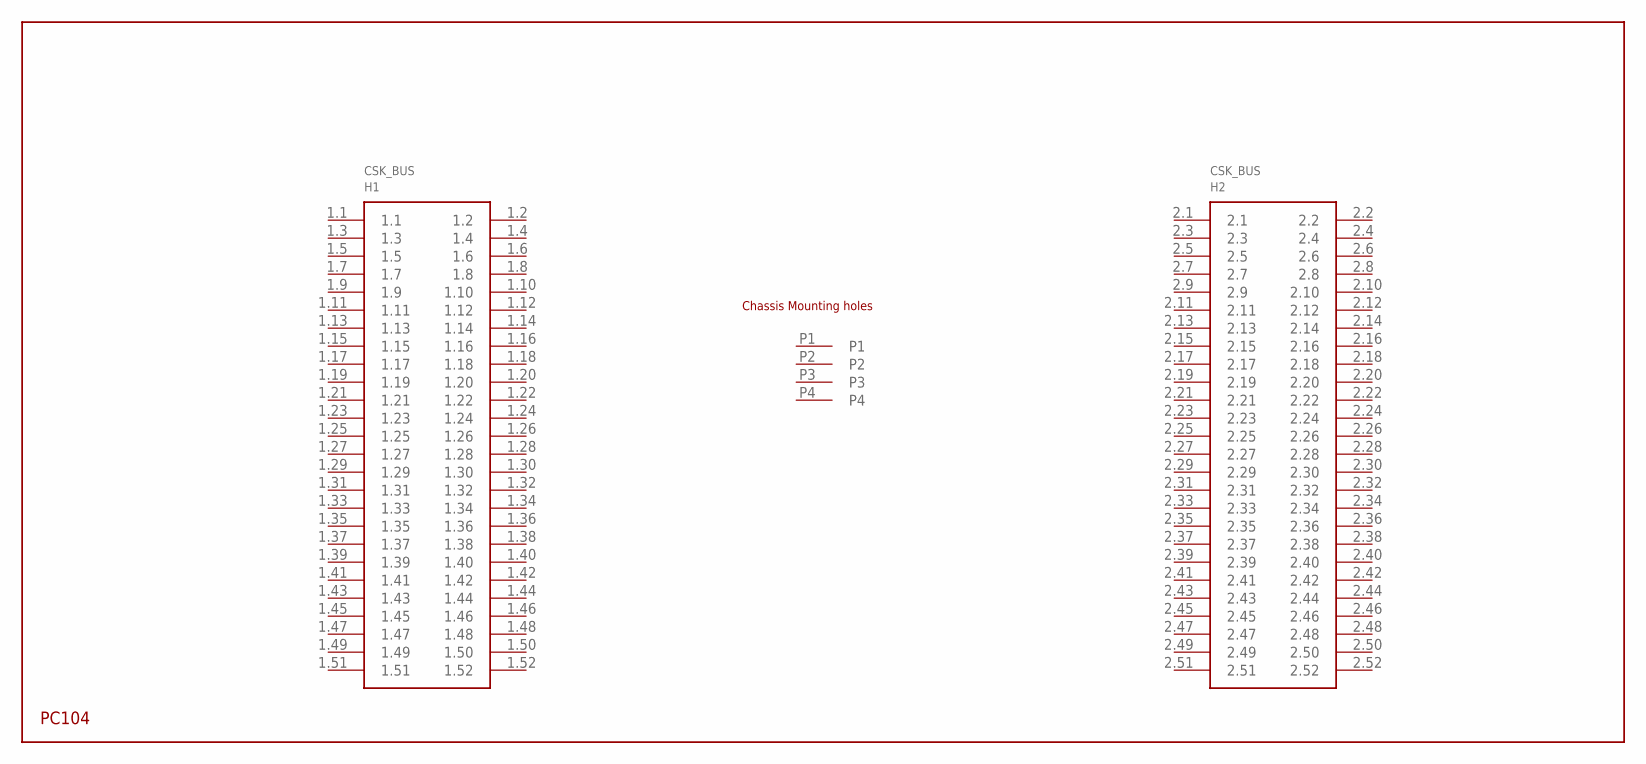
[picture p17: schematic eps.sch, sheet 1]

Parts:
H1: PC104_WCONN

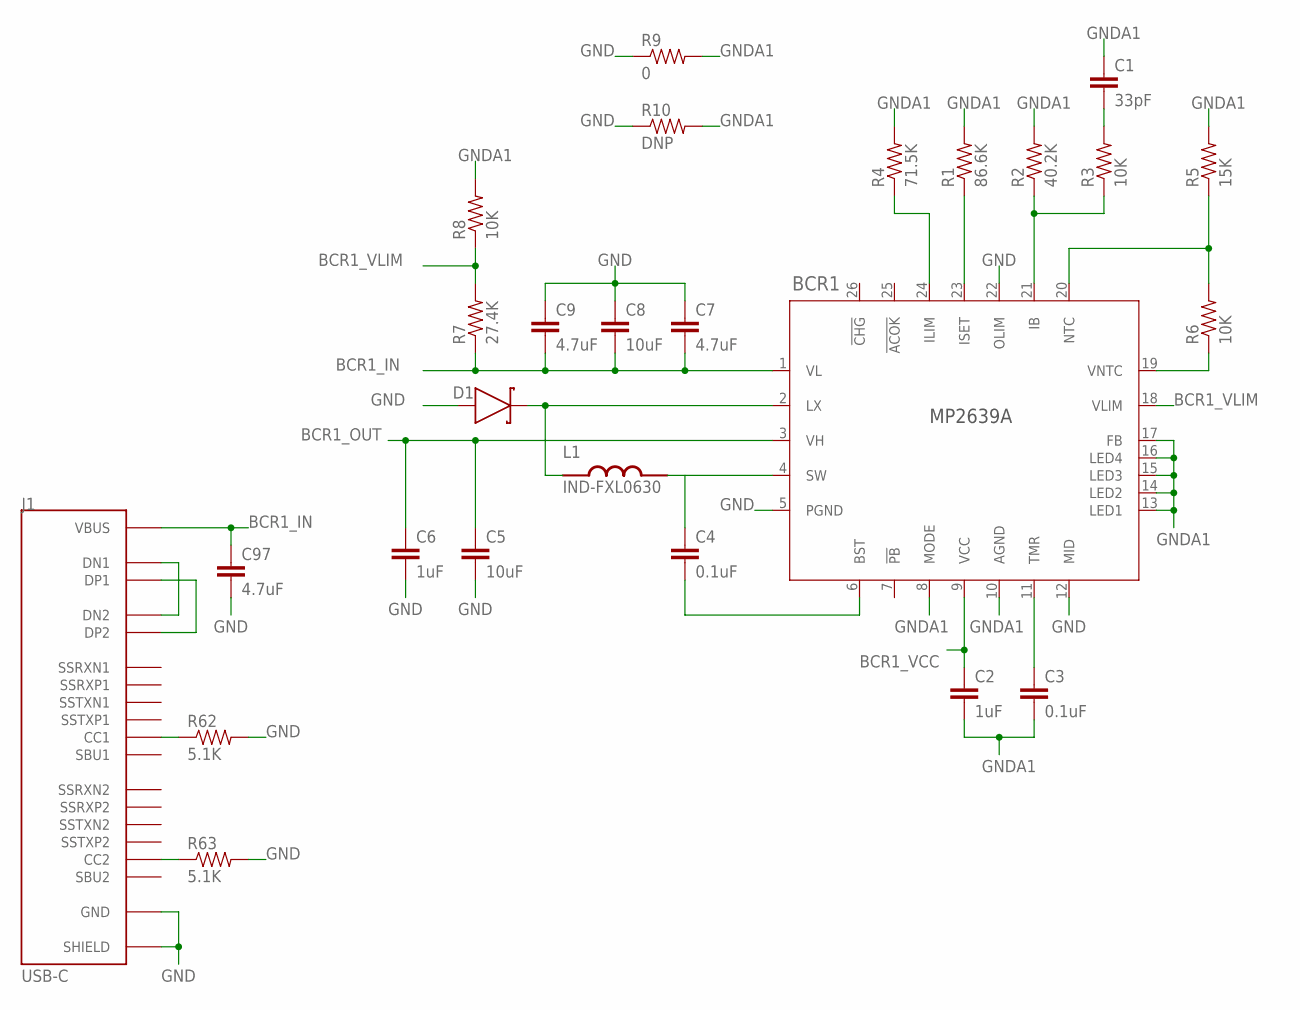
[picture p18: schematic eps.sch, sheet 2]

Parts:
BCR1: MP2639A; IC26_MP2639A_MNP
C1: 33pF; 0603-CAP
C2, C6: 1uF; 0603-CAP
C3, C4: 0.1uF; 0603-CAP
C5, C8: 10uF; 0603-CAP
C7, C9, C97: 4.7uF; 0603-CAP
D1: DIODE-SOD123; SOD123
J1: USB-C; CUI_UJ31-CH-G1-SMT-TR
L1: IND-FXL0630; FXL0630
R1: 86.6K; 0603-RES
R2: 40.2K; 0603-RES
R3, R6, R8: 10K; 0603-RES
R4: 71.5K; 0603-RES
R5: 15K; 0603-RES
R7: 27.4K; 0603-RES
R9: 0; 0603-RES
R10: DNP; 0603-RES
R62, R63: 5.1K; 0603-RES

Connections:
BCR1_BST: BCR1.6 (BST), C4.2
BCR1_C1-R3: C1.2, R3.2
BCR1_IB: BCR1.21 (IB), R2.1, R3.1
BCR1_ILIM: BCR1.24 (ILIM), R4.1
BCR1_IN: BCR1.1 (VL), C7.2, C8.2, C9.2, C97.1, J1.A4 (VBUS), R7.1
BCR1_ISET: BCR1.23 (ISET), R1.1
BCR1_LX: BCR1.2 (LX), D1.1 (2), L1.1
BCR1_NTC: BCR1.20 (NTC), R5.1, R6.2
BCR1_OUT: BCR1.3 (VH), C5.1, C6.1
BCR1_SW: BCR1.4 (SW), C4.1, L1.2
BCR1_TMR: BCR1.11 (TMR), C3.1
BCR1_VCC: BCR1.9 (VCC), C2.1
BCR1_VLIM: BCR1.18 (VLIM), R7.2, R8.1
BCR1_VNTC: BCR1.19 (VNTC), R6.1
GND: BCR1.5 (PGND), BCR1.12 (MID), BCR1.22 (OLIM), C5.2, C6.2, C7.1, C8.1, C9.1, C97.2, D1.2 (1), J1.A1 (GND), J1.SH1 (SHIELD), R9.1, R10.1, R62.2, R63.2
GNDA1: BCR1.8 (MODE), BCR1.10 (AGND), BCR1.13 (LED1), BCR1.14 (LED2), BCR1.15 (LED3), BCR1.16 (LED4), BCR1.17 (FB), C1.1, C2.2, C3.2, R1.2, R2.2, R4.2, R5.2, R8.2, R9.2, R10.2
J1_CC1: J1.A5 (CC1), R62.1
J1_CC2: J1.B5 (CC2), R63.1
J1_DN: J1.A7 (DN1), J1.B7 (DN2)
J1_DP: J1.A6 (DP1), J1.B6 (DP2)

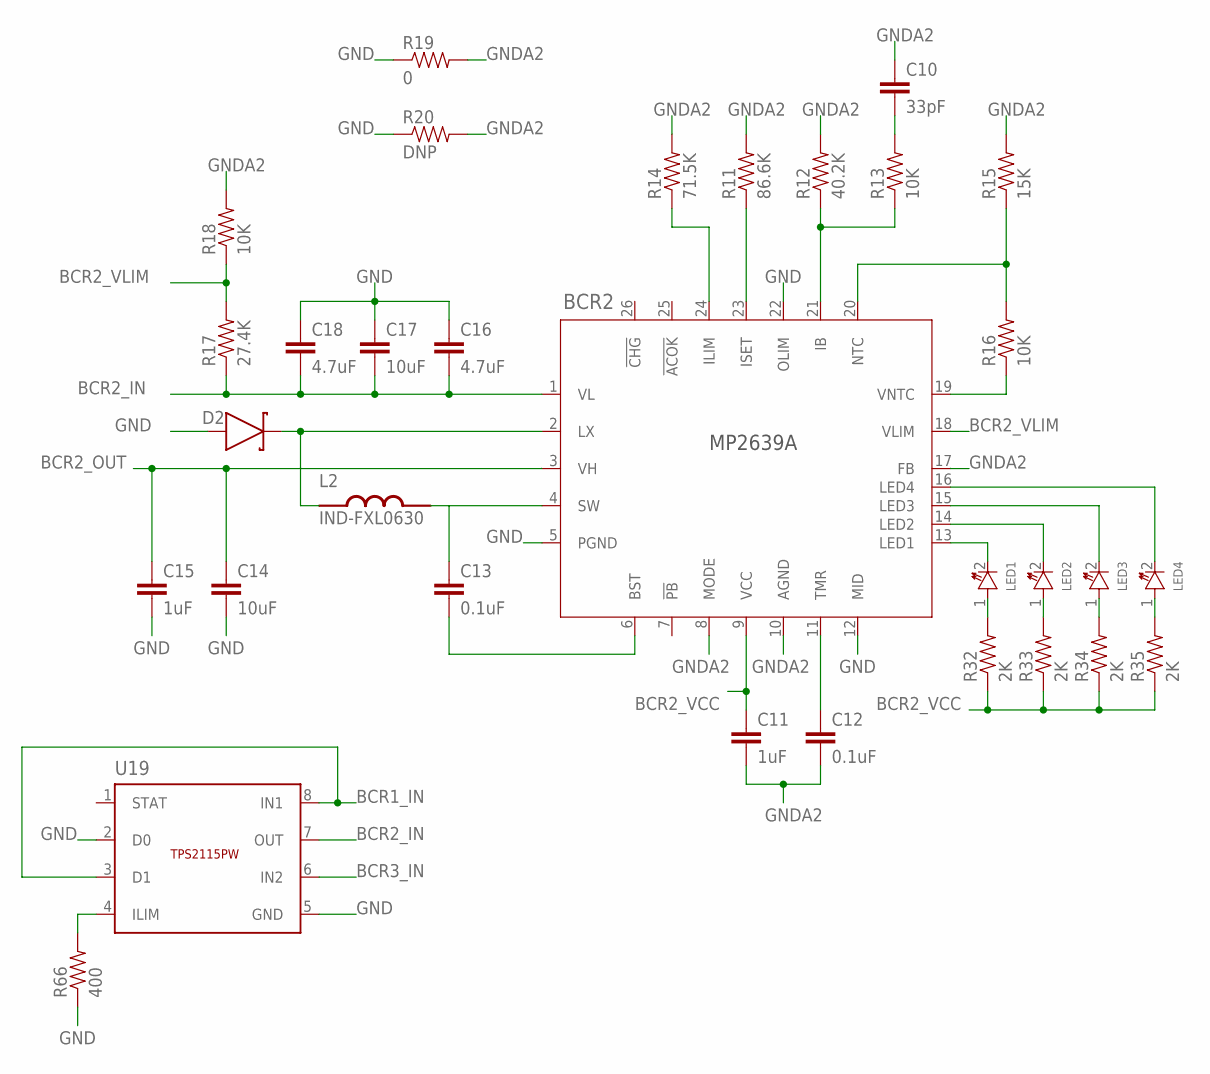
[picture p19: schematic eps.sch, sheet 3]

Parts:
BCR2: MP2639A; IC26_MP2639A_MNP
C10: 33pF; 0603-CAP
C11, C15: 1uF; 0603-CAP
C12, C13: 0.1uF; 0603-CAP
C14, C17: 10uF; 0603-CAP
C16, C18: 4.7uF; 0603-CAP
D2: DIODE-SOD123; SOD123
L2: IND-FXL0630; FXL0630
LED1, LED2, LED3, LED4: LED_0805
R11: 86.6K; 0603-RES
R12: 40.2K; 0603-RES
R13, R16, R18: 10K; 0603-RES
R14: 71.5K; 0603-RES
R15: 15K; 0603-RES
R17: 27.4K; 0603-RES
R19: 0; 0603-RES
R20: DNP; 0603-RES
R32, R33, R34, R35: 2K; 0603-RES
R66: 400; 0603-RES
U19: TPS2115PW; TTSOP-8

Connections:
BCR1_IN: U19.3 (D1), U19.8 (IN1)
BCR2_BST: BCR2.6 (BST), C13.2
BCR2_C10-R13: C10.2, R13.2
BCR2_IB2: BCR2.21 (IB), R12.1, R13.1
BCR2_ILIM: BCR2.24 (ILIM), R14.1
BCR2_IN: BCR2.1 (VL), C16.2, C17.2, C18.2, R17.1, U19.7 (OUT)
BCR2_ISET: BCR2.23 (ISET), R11.1
BCR2_LED1: BCR2.13 (LED1), LED1.2
BCR2_LED2: BCR2.14 (LED2), LED2.2
BCR2_LED3: BCR2.15 (LED3), LED3.2
BCR2_LED4: BCR2.16 (LED4), LED4.2
BCR2_LX: BCR2.2 (LX), D2.1 (2), L2.1
BCR2_NTC: BCR2.20 (NTC), R15.1, R16.2
BCR2_OUT: BCR2.3 (VH), C14.1, C15.1
BCR2_SW: BCR2.4 (SW), C13.1, L2.2
BCR2_TMR: BCR2.11 (TMR), C12.1
BCR2_VCC: BCR2.9 (VCC), C11.1, R32.1, R33.1, R34.1, R35.1
BCR2_VLIM: BCR2.18 (VLIM), R17.2, R18.1
BCR2_VNTC: BCR2.19 (VNTC), R16.1
BCR3_IN: U19.6 (IN2)
GND: BCR2.5 (PGND), BCR2.12 (MID), BCR2.22 (OLIM), C14.2, C15.2, C16.1, C17.1, C18.1, D2.2 (1), R19.1, R20.1, R66.1, U19.2 (D0), U19.5 (GND)
GNDA2: BCR2.8 (MODE), BCR2.10 (AGND), BCR2.17 (FB), C10.1, C11.2, C12.2, R11.2, R12.2, R14.2, R15.2, R18.2, R19.2, R20.2
LED1: LED1.1, R32.2
LED2: LED2.1, R33.2
LED3: LED3.1, R34.2
LED4: LED4.1, R35.2
U19_ILIM: R66.2, U19.4 (ILIM)

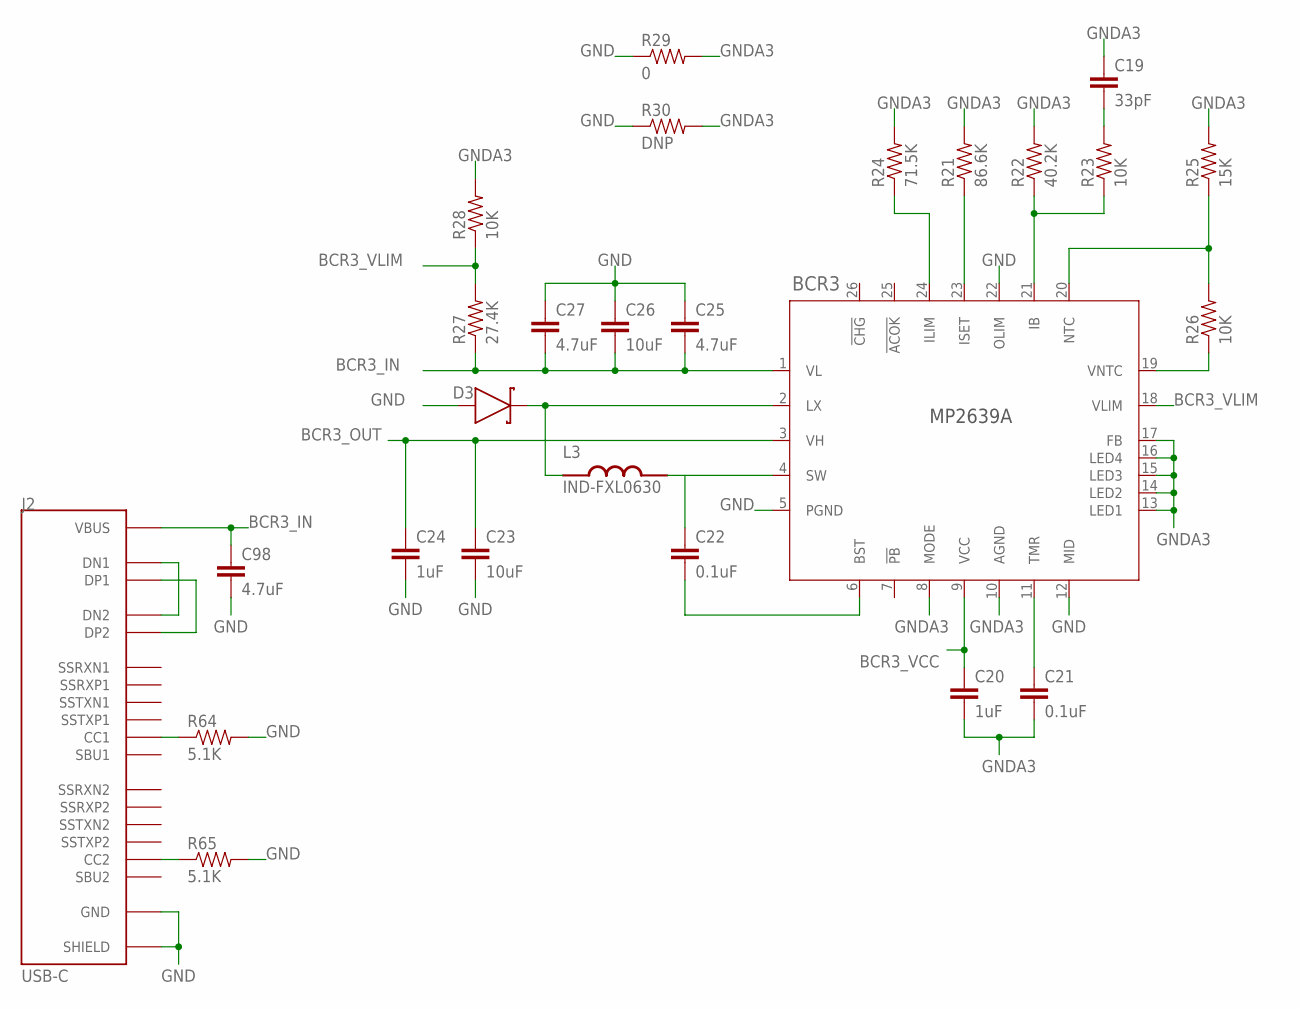
[picture p20: schematic eps.sch, sheet 4]

Parts:
BCR3: MP2639A; IC26_MP2639A_MNP
C19: 33pF; 0603-CAP
C20, C24: 1uF; 0603-CAP
C21, C22: 0.1uF; 0603-CAP
C23, C26: 10uF; 0603-CAP
C25, C27, C98: 4.7uF; 0603-CAP
D3: DIODE-SOD123; SOD123
J2: USB-C; CUI_UJ31-CH-G1-SMT-TR
L3: IND-FXL0630; FXL0630
R21: 86.6K; 0603-RES
R22: 40.2K; 0603-RES
R23, R26, R28: 10K; 0603-RES
R24: 71.5K; 0603-RES
R25: 15K; 0603-RES
R27: 27.4K; 0603-RES
R29: 0; 0603-RES
R30: DNP; 0603-RES
R64, R65: 5.1K; 0603-RES

Connections:
BCR3_BST: BCR3.6 (BST), C22.2
BCR3_C19-R23: C19.2, R23.2
BCR3_IB: BCR3.21 (IB), R22.1, R23.1
BCR3_ILIM: BCR3.24 (ILIM), R24.1
BCR3_IN: BCR3.1 (VL), C25.2, C26.2, C27.2, C98.1, J2.A4 (VBUS), R27.1
BCR3_ISET: BCR3.23 (ISET), R21.1
BCR3_LX: BCR3.2 (LX), D3.1 (2), L3.1
BCR3_NTC: BCR3.20 (NTC), R25.1, R26.2
BCR3_OUT: BCR3.3 (VH), C23.1, C24.1
BCR3_SW: BCR3.4 (SW), C22.1, L3.2
BCR3_TMR: BCR3.11 (TMR), C21.1
BCR3_VCC: BCR3.9 (VCC), C20.1
BCR3_VLIM: BCR3.18 (VLIM), R27.2, R28.1
BCR3_VNTC: BCR3.19 (VNTC), R26.1
GND: BCR3.5 (PGND), BCR3.12 (MID), BCR3.22 (OLIM), C23.2, C24.2, C25.1, C26.1, C27.1, C98.2, D3.2 (1), J2.A1 (GND), J2.SH1 (SHIELD), R29.1, R30.1, R64.2, R65.2
GNDA3: BCR3.8 (MODE), BCR3.10 (AGND), BCR3.13 (LED1), BCR3.14 (LED2), BCR3.15 (LED3), BCR3.16 (LED4), BCR3.17 (FB), C19.1, C20.2, C21.2, R21.2, R22.2, R24.2, R25.2, R28.2, R29.2, R30.2
J2_CC1: J2.A5 (CC1), R64.1
J2_CC2: J2.B5 (CC2), R65.1
J2_DN: J2.A7 (DN1), J2.B7 (DN2)
J2_DP: J2.A6 (DP1), J2.B6 (DP2)

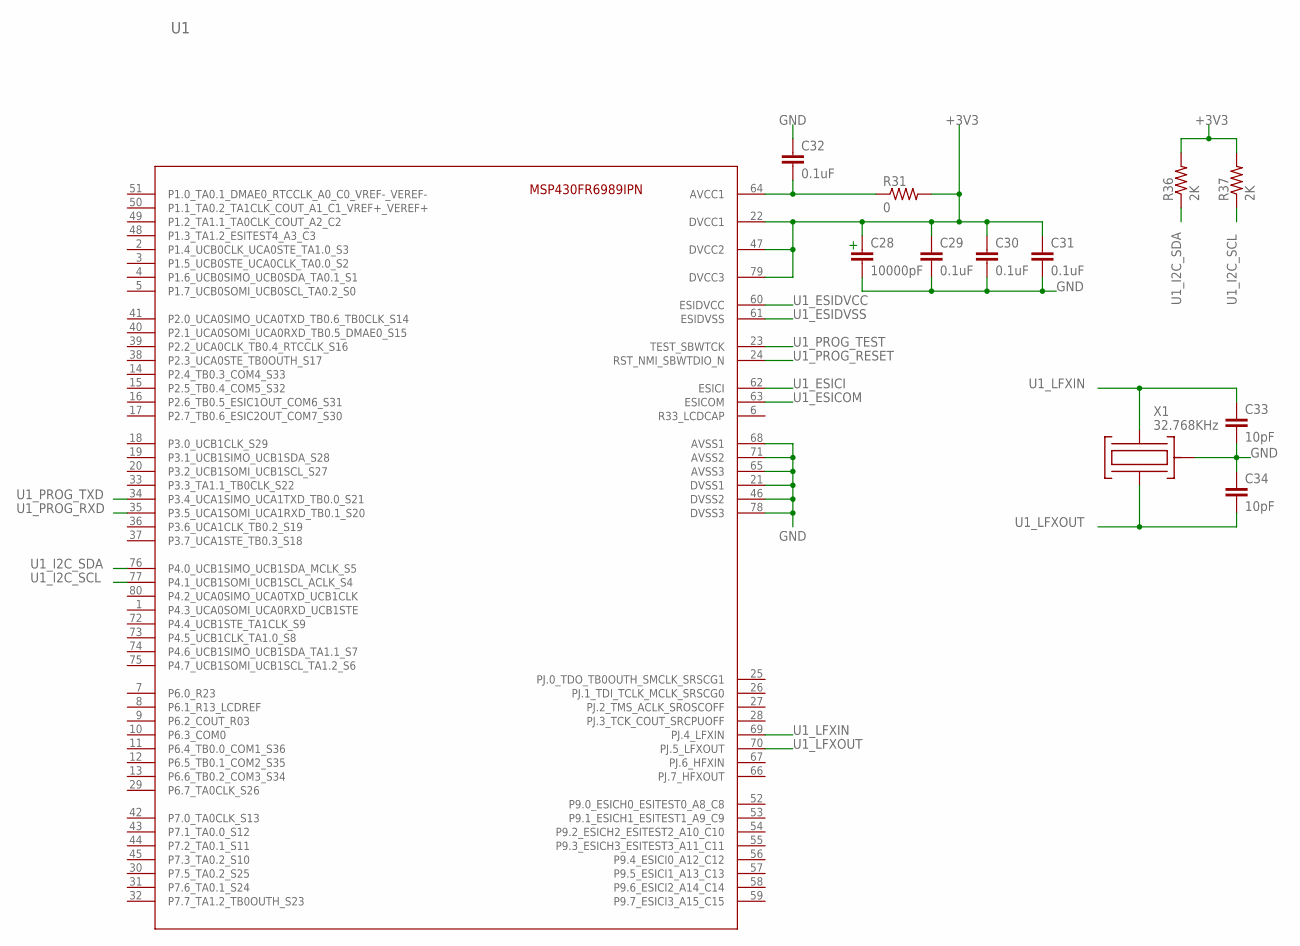
[picture p21: schematic eps.sch, sheet 5]

Parts:
C28: 10000pF; 0805
C29, C30, C31, C32: 0.1uF; 0603-CAP
C33, C34: 10pF; 0603-CAP
R31: 0; 0603-RES
R36, R37: 2K; 0603-RES
U1: MSP430FR6989IPN; PN0080A_N
X1: 32.768KHz; MS3V-T1R

Connections:
+3V3: C28.1, C29.1, C30.1, C31.1, R31.2, R36.2, R37.2, U1.22 (DVCC1), U1.47 (DVCC2), U1.79 (DVCC3)
GND: C28.2, C29.2, C30.2, C31.2, C32.1, C33.2, C34.1, U1.21 (DVSS1), U1.46 (DVSS2), U1.65 (AVSS3), U1.68 (AVSS1), U1.71 (AVSS2), U1.78 (DVSS3), X1.3
unnamed: C32.2, R31.1, U1.64 (AVCC1)
U1_ESICI: U1.62 (ESICI)
U1_ESICOM: U1.63 (ESICOM)
U1_ESIDVCC: U1.60 (ESIDVCC)
U1_ESIDVSS: U1.61 (ESIDVSS)
U1_I2C_SCL: R37.1, U1.77 (P4.1_UCB1SOMI_UCB1SCL_ACLK_S4)
U1_I2C_SDA: R36.1, U1.76 (P4.0_UCB1SIMO_UCB1SDA_MCLK_S5)
U1_LFXIN: C33.1, U1.69 (PJ.4_LFXIN), X1.1
U1_LFXOUT: C34.2, U1.70 (PJ.5_LFXOUT), X1.2
U1_PROG_RESET: U1.24 (RST_NMI_SBWTDIO_N)
U1_PROG_RXD: U1.35 (P3.5_UCA1SOMI_UCA1RXD_TB0.1_S20)
U1_PROG_TEST: U1.23 (TEST_SBWTCK)
U1_PROG_TXD: U1.34 (P3.4_UCA1SIMO_UCA1TXD_TB0.0_S21)

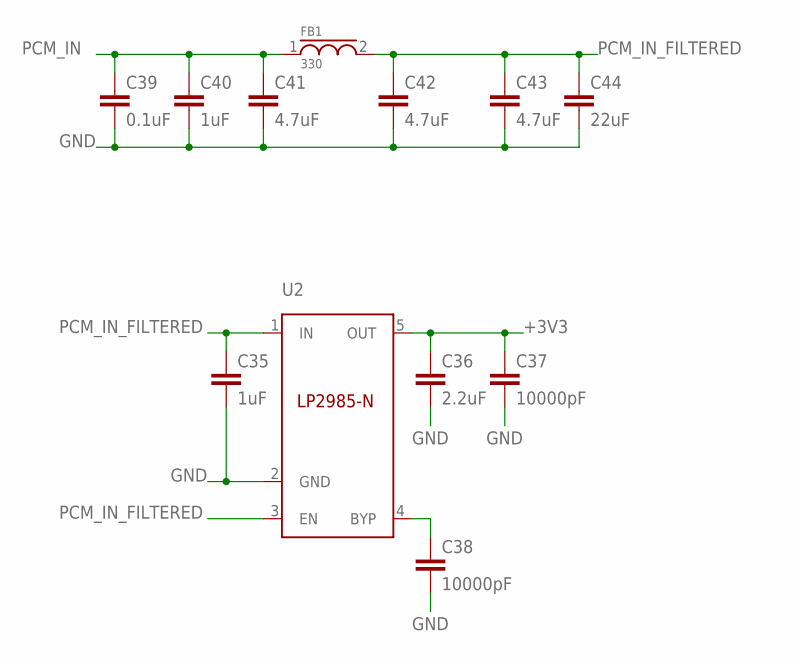
[picture p22: schematic eps.sch, sheet 6]

Parts:
C35, C40: 1uF; 0603-CAP
C36: 2.2uF; 0603-CAP
C37, C38: 10000pF; 0603-CAP
C39: 0.1uF; 0603-CAP
C41, C42, C43: 4.7uF; 1206
C44: 22uF; 2917
FB1: 330; 0805
U2: LP2985-N; SOT23-5

Connections:
+3V3: C36.1, C37.1, U2.5 (OUT)
GND: C35.2, C36.2, C37.2, C38.2, C39.2, C40.2, C41.2, C42.2, C43.2, C44.2, U2.2 (GND)
unnamed: C38.1, U2.4 (BYP)
PCM_IN: C39.1, C40.1, C41.1, FB1.1
PCM_IN_FILTERED: C35.1, C42.1, C43.1, C44.1, FB1.2, U2.1 (IN), U2.3 (EN)

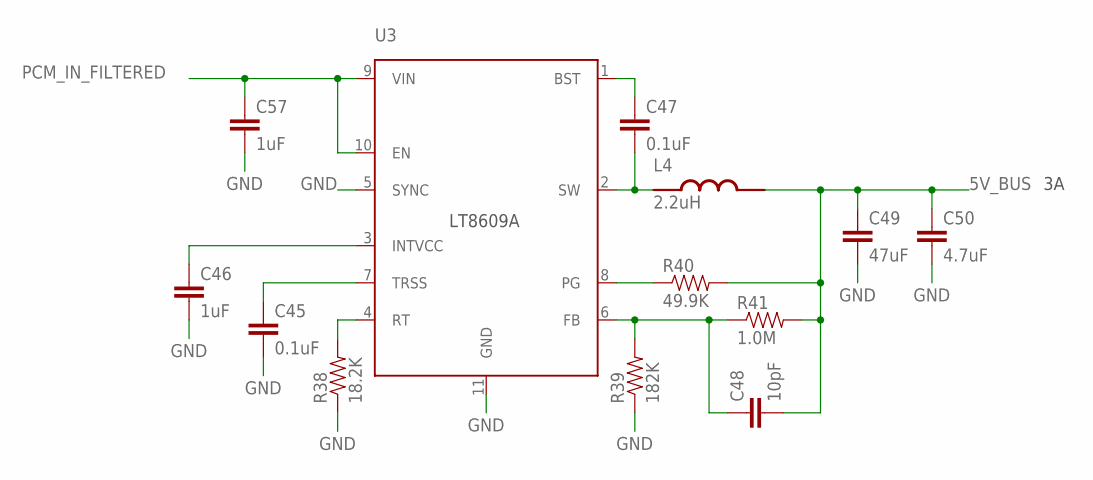
[picture p23: schematic eps.sch, sheet 7]

Parts:
C45, C47: 0.1uF; 0603-CAP
C46, C57: 1uF; 0603-CAP
C48: 10pF; 0603-CAP
C49: 47uF; 0805
C50: 4.7uF; 0603-CAP
L4: 2.2uH; XFL4020
R38: 18.2K; 0603-RES
R39: 182K; 0603-RES
R40: 49.9K; 0603-RES
R41: 1.0M; 0603-RES
U3: LT8609A; MSOP-10_MSE

Connections:
5V_BUS: C48.2, C49.1, C50.1, L4.2, R40.2, R41.2
GND: C45.2, C46.2, C49.2, C50.2, C57.2, R38.1, R39.1, U3.5 (SYNC), U3.11 (GND)
PCM_IN_FILTERED: C57.1, U3.9 (VIN), U3.10 (EN)
U3_BST: C47.1, U3.1 (BST)
U3_FB: C48.1, R39.2, R41.1, U3.6 (FB)
U3_INTVCC: C46.1, U3.3 (INTVCC)
U3_PG: R40.1, U3.8 (PG)
U3_RT: R38.2, U3.4 (RT)
U3_SW: C47.2, L4.1, U3.2 (SW)
U3_TRSS: C45.1, U3.7 (TRSS)

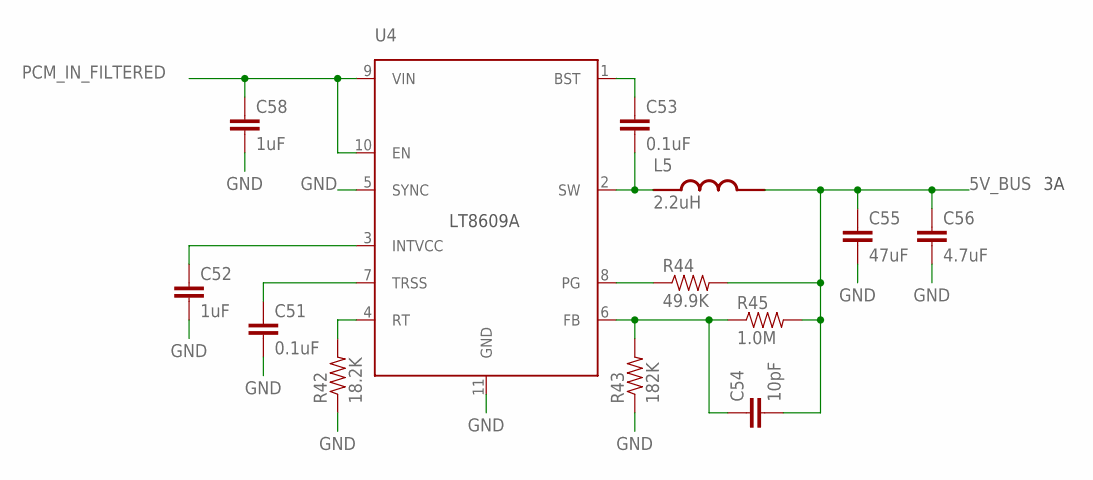
[picture p24: schematic eps.sch, sheet 8]

Parts:
C51, C53: 0.1uF; 0603-CAP
C52, C58: 1uF; 0603-CAP
C54: 10pF; 0603-CAP
C55: 47uF; 0805
C56: 4.7uF; 0603-CAP
L5: 2.2uH; XFL4020
R42: 18.2K; 0603-RES
R43: 182K; 0603-RES
R44: 49.9K; 0603-RES
R45: 1.0M; 0603-RES
U4: LT8609A; MSOP-10_MSE

Connections:
5V_BUS: C54.2, C55.1, C56.1, L5.2, R44.2, R45.2
GND: C51.2, C52.2, C55.2, C56.2, C58.2, R42.1, R43.1, U4.5 (SYNC), U4.11 (GND)
PCM_IN_FILTERED: C58.1, U4.9 (VIN), U4.10 (EN)
U4_BST: C53.1, U4.1 (BST)
U4_FB: C54.1, R43.2, R45.1, U4.6 (FB)
U4_INTVCC: C52.1, U4.3 (INTVCC)
U4_PG: R44.1, U4.8 (PG)
U4_RT: R42.2, U4.4 (RT)
U4_SW: C53.2, L5.1, U4.2 (SW)
U4_TRSS: C51.1, U4.7 (TRSS)

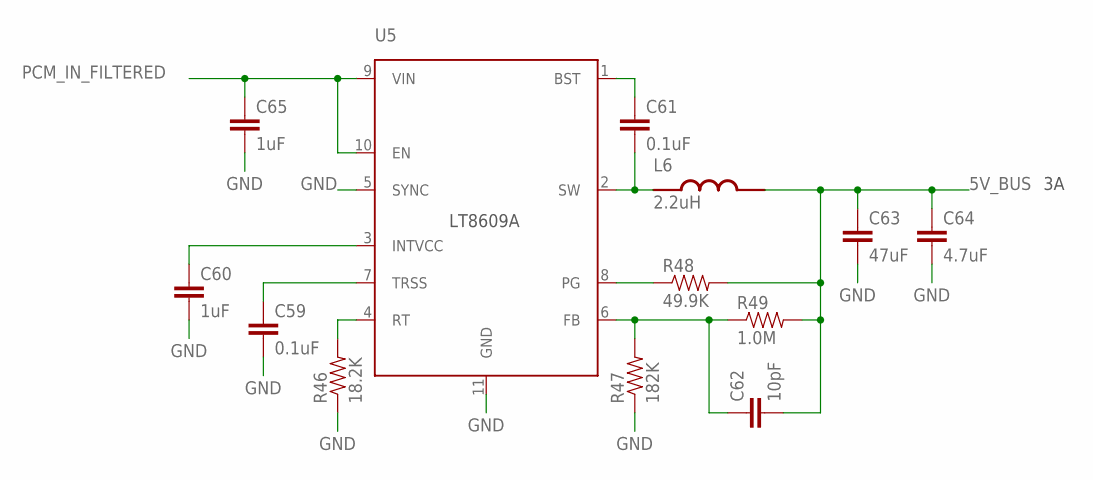
[picture p25: schematic eps.sch, sheet 9]

Parts:
C59, C61: 0.1uF; 0603-CAP
C60, C65: 1uF; 0603-CAP
C62: 10pF; 0603-CAP
C63: 47uF; 0805
C64: 4.7uF; 0603-CAP
L6: 2.2uH; XFL4020
R46: 18.2K; 0603-RES
R47: 182K; 0603-RES
R48: 49.9K; 0603-RES
R49: 1.0M; 0603-RES
U5: LT8609A; MSOP-10_MSE

Connections:
5V_BUS: C62.2, C63.1, C64.1, L6.2, R48.2, R49.2
GND: C59.2, C60.2, C63.2, C64.2, C65.2, R46.1, R47.1, U5.5 (SYNC), U5.11 (GND)
PCM_IN_FILTERED: C65.1, U5.9 (VIN), U5.10 (EN)
U5_BST: C61.1, U5.1 (BST)
U5_FB: C62.1, R47.2, R49.1, U5.6 (FB)
U5_INTVCC: C60.1, U5.3 (INTVCC)
U5_PG: R48.1, U5.8 (PG)
U5_RT: R46.2, U5.4 (RT)
U5_SW: C61.2, L6.1, U5.2 (SW)
U5_TRSS: C59.1, U5.7 (TRSS)

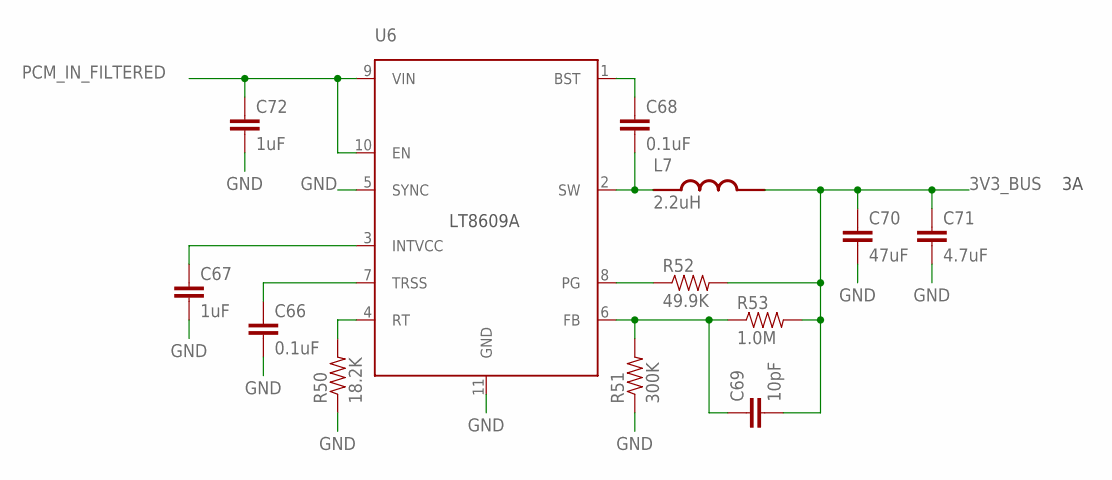
[picture p26: schematic eps.sch, sheet 10]

Parts:
C66, C68: 0.1uF; 0603-CAP
C67, C72: 1uF; 0603-CAP
C69: 10pF; 0603-CAP
C70: 47uF; 0805
C71: 4.7uF; 0603-CAP
L7: 2.2uH; XFL4020
R50: 18.2K; 0603-RES
R51: 300K; 0603-RES
R52: 49.9K; 0603-RES
R53: 1.0M; 0603-RES
U6: LT8609A; MSOP-10_MSE

Connections:
3V3_BUS: C69.2, C70.1, C71.1, L7.2, R52.2, R53.2
GND: C66.2, C67.2, C70.2, C71.2, C72.2, R50.1, R51.1, U6.5 (SYNC), U6.11 (GND)
PCM_IN_FILTERED: C72.1, U6.9 (VIN), U6.10 (EN)
U6_BST: C68.1, U6.1 (BST)
U6_FB: C69.1, R51.2, R53.1, U6.6 (FB)
U6_INTVCC: C67.1, U6.3 (INTVCC)
U6_PG: R52.1, U6.8 (PG)
U6_RT: R50.2, U6.4 (RT)
U6_SW: C68.2, L7.1, U6.2 (SW)
U6_TRSS: C66.1, U6.7 (TRSS)

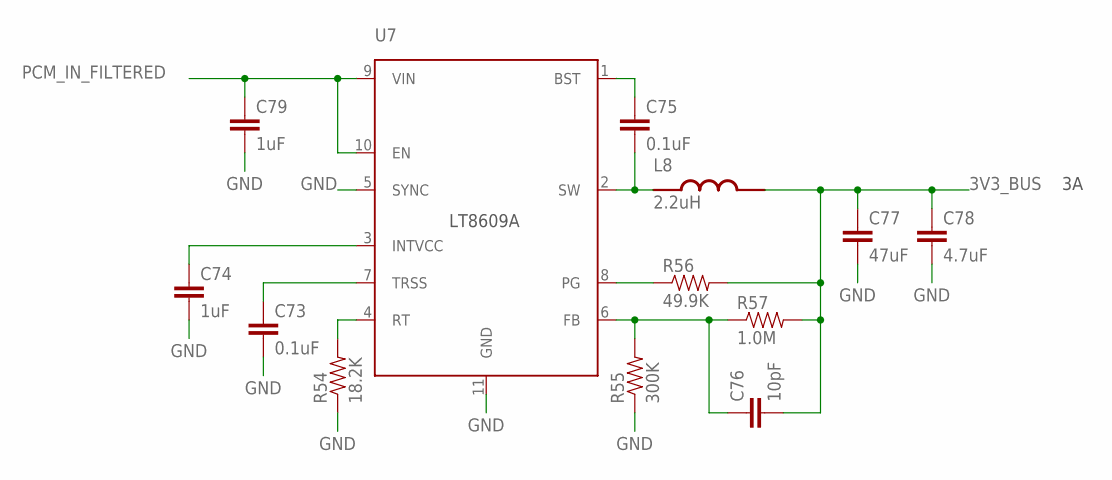
[picture p27: schematic eps.sch, sheet 11]

Parts:
C73, C75: 0.1uF; 0603-CAP
C74, C79: 1uF; 0603-CAP
C76: 10pF; 0603-CAP
C77: 47uF; 0805
C78: 4.7uF; 0603-CAP
L8: 2.2uH; XFL4020
R54: 18.2K; 0603-RES
R55: 300K; 0603-RES
R56: 49.9K; 0603-RES
R57: 1.0M; 0603-RES
U7: LT8609A; MSOP-10_MSE

Connections:
3V3_BUS: C76.2, C77.1, C78.1, L8.2, R56.2, R57.2
GND: C73.2, C74.2, C77.2, C78.2, C79.2, R54.1, R55.1, U7.5 (SYNC), U7.11 (GND)
PCM_IN_FILTERED: C79.1, U7.9 (VIN), U7.10 (EN)
U7_BST: C75.1, U7.1 (BST)
U7_FB: C76.1, R55.2, R57.1, U7.6 (FB)
U7_INTVCC: C74.1, U7.3 (INTVCC)
U7_PG: R56.1, U7.8 (PG)
U7_RT: R54.2, U7.4 (RT)
U7_SW: C75.2, L8.1, U7.2 (SW)
U7_TRSS: C73.1, U7.7 (TRSS)

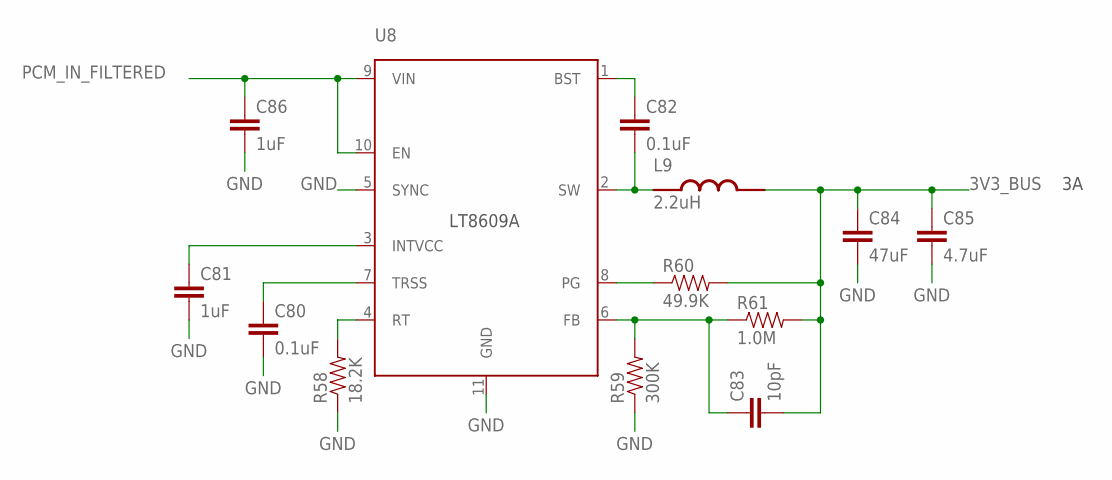
[picture p28: schematic eps.sch, sheet 12]

Parts:
C80, C82: 0.1uF; 0603-CAP
C81, C86: 1uF; 0603-CAP
C83: 10pF; 0603-CAP
C84: 47uF; 0805
C85: 4.7uF; 0603-CAP
L9: 2.2uH; XFL4020
R58: 18.2K; 0603-RES
R59: 300K; 0603-RES
R60: 49.9K; 0603-RES
R61: 1.0M; 0603-RES
U8: LT8609A; MSOP-10_MSE

Connections:
3V3_BUS: C83.2, C84.1, C85.1, L9.2, R60.2, R61.2
GND: C80.2, C81.2, C84.2, C85.2, C86.2, R58.1, R59.1, U8.5 (SYNC), U8.11 (GND)
PCM_IN_FILTERED: C86.1, U8.9 (VIN), U8.10 (EN)
U8_BST: C82.1, U8.1 (BST)
U8_FB: C83.1, R59.2, R61.1, U8.6 (FB)
U8_INTVCC: C81.1, U8.3 (INTVCC)
U8_PG: R60.1, U8.8 (PG)
U8_RT: R58.2, U8.4 (RT)
U8_SW: C82.2, L9.1, U8.2 (SW)
U8_TRSS: C80.1, U8.7 (TRSS)

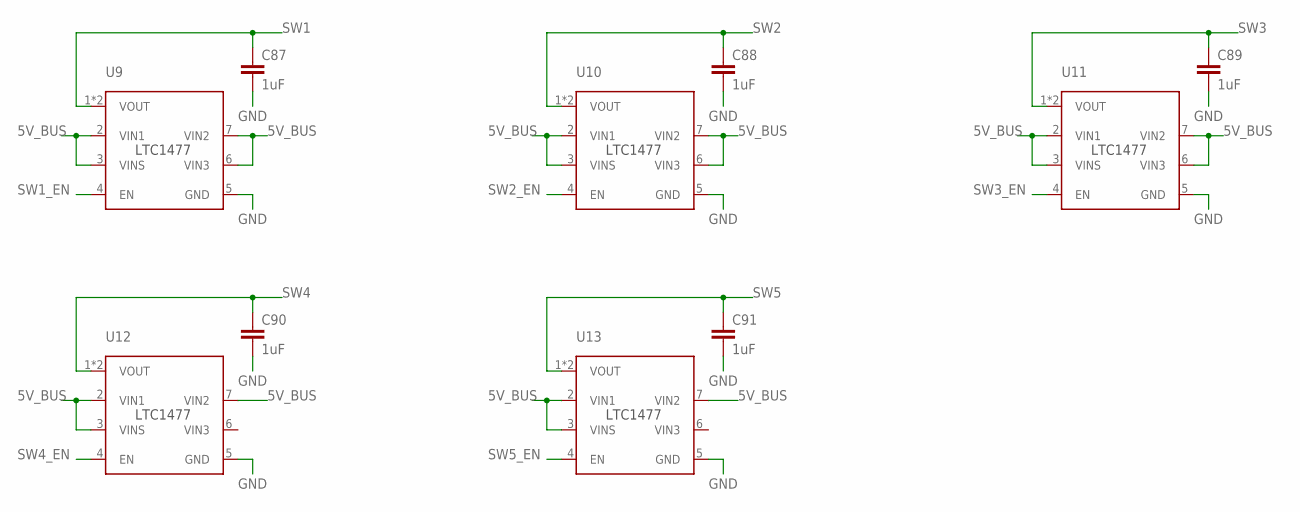
[picture p29: schematic eps.sch, sheet 13]

Parts:
C87, C88, C89, C90, C91: 1uF; 0603-CAP
U9, U10, U11, U12, U13: LTC1477; SO8

Connections:
5V_BUS: U9.2 (VIN1), U9.3 (VINS), U9.6 (VIN3), U9.7 (VIN2), U10.2 (VIN1), U10.3 (VINS), U10.6 (VIN3), U10.7 (VIN2), U11.2 (VIN1), U11.3 (VINS), U11.6 (VIN3), U11.7 (VIN2), U12.2 (VIN1), U12.3 (VINS), U12.7 (VIN2), U13.2 (VIN1), U13.3 (VINS), U13.7 (VIN2)
GND: C87.2, C88.2, C89.2, C90.2, C91.2, U9.5 (GND), U10.5 (GND), U11.5 (GND), U12.5 (GND), U13.5 (GND)
SW1: C87.1, U9.1 (VOUT)
SW1_EN: U9.4 (EN)
SW2: C88.1, U10.1 (VOUT)
SW2_EN: U10.4 (EN)
SW3: C89.1, U11.1 (VOUT)
SW3_EN: U11.4 (EN)
SW4: C90.1, U12.1 (VOUT)
SW4_EN: U12.4 (EN)
SW5: C91.1, U13.1 (VOUT)
SW5_EN: U13.4 (EN)

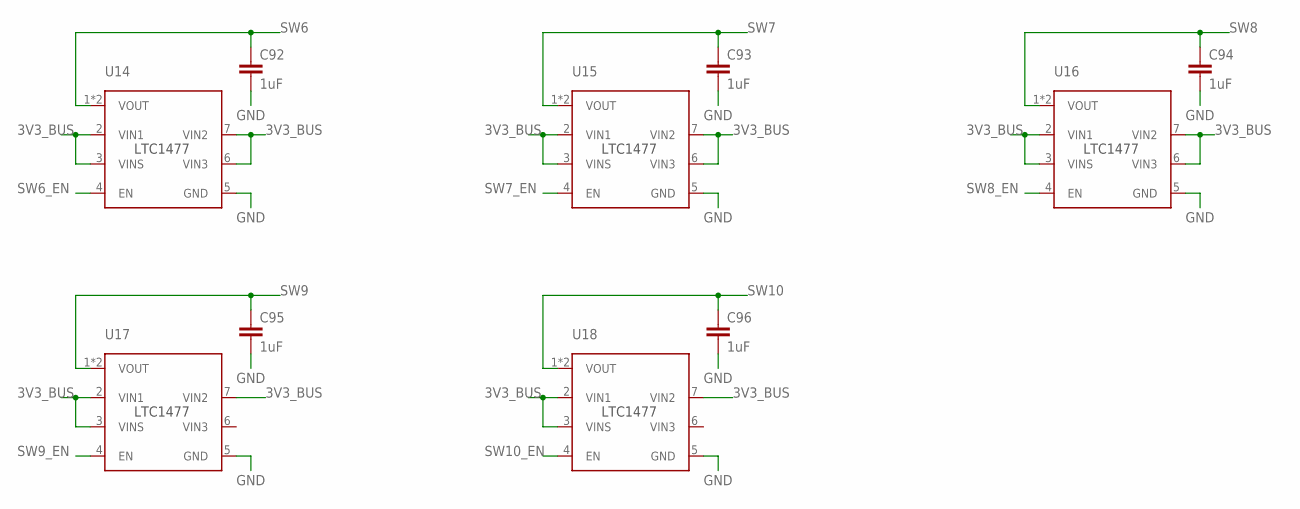
[picture p30: schematic eps.sch, sheet 14]

Parts:
C92, C93, C94, C95, C96: 1uF; 0603-CAP
U14, U15, U16, U17, U18: LTC1477; SO8

Connections:
3V3_BUS: U14.2 (VIN1), U14.3 (VINS), U14.6 (VIN3), U14.7 (VIN2), U15.2 (VIN1), U15.3 (VINS), U15.6 (VIN3), U15.7 (VIN2), U16.2 (VIN1), U16.3 (VINS), U16.6 (VIN3), U16.7 (VIN2), U17.2 (VIN1), U17.3 (VINS), U17.7 (VIN2), U18.2 (VIN1), U18.3 (VINS), U18.7 (VIN2)
GND: C92.2, C93.2, C94.2, C95.2, C96.2, U14.5 (GND), U15.5 (GND), U16.5 (GND), U17.5 (GND), U18.5 (GND)
SW6: C92.1, U14.1 (VOUT)
SW6_EN: U14.4 (EN)
SW7: C93.1, U15.1 (VOUT)
SW7_EN: U15.4 (EN)
SW8: C94.1, U16.1 (VOUT)
SW8_EN: U16.4 (EN)
SW9: C95.1, U17.1 (VOUT)
SW9_EN: U17.4 (EN)
SW10: C96.1, U18.1 (VOUT)
SW10_EN: U18.4 (EN)
