UHM-RoSE/instrumentation-and-control/(commit log)

2021-10-01 added UART interface to MSP430FR6989
2021-10-07 added systemInit for configuring GPIOs at startup for low power consumption
2021-10-08 added documentation for the battery and uploaded current status of EPS ICD
2021-10-13 added eagle files
    [eps.sch]
2021-12-09 updated references
    [main.obj, uart.obj]
