UHM-RoSE/instrumentation-and-control/(notices)

Notices in the files:
parts and their libraries:
DSD_Active_Library: COPYRIGHT: Copyright (C) 2021 DSD. All rights reserved
